SmartEVSE/SmartEVSE-2/(threads)

Thread 2 (2021-03-06):

Reading Modbus interface EVSE

rvdgaag, 2021-03-06:
Hi,

I'm trying to read registers via Modbus RTU from the EVSE with iobroker and a USB-modbus converter.
All works well reading the SDM630 I connected as well but I don't get any values for the EVSE.

As an example I try to read the register 0x00C0 Configuration value 0 socket, value 1 fixed.
I've set in the menu of the EVSE the configuration to fixed cable, still reading this register comes with value 0.

Probably the register setting is wrong in iobroker, is it a input register, a coil or a holding register ?

Since these registers are in HEX format I need to convert them, 192 right ?

Maybe the issue is that the EVSE is a Master and probably the iobroker (raspi 4) as well ?

Thanks for your feedback!

bobosch, 2021-03-06:
Hi,

when you use load balancing mode it's an issue with two masters. SmartEVSE sends multiple requests every two seconds - you have to try multiple times to get a valid response.

Have you tried communication when load balancing and smart/solar mode is disabled?

rvdgaag, 2021-03-06:
Thanks for the feedback,

yes I did not much better results. I was hoping to change parameters from remote, any ideas ?

bobosch, 2021-03-07:
Maybe wrong byte order. Set it on the SmartEVSE to fixed configuration and read value again.
Yes, it is a input register (FC=04).
Yes, addresses are in HEX format (0x indicates that)
Also correct settings? 9600bps 8N1 (8bit, no parity bit, one stop bit)
Do you have a modbus electric meter? Does your adapter work with this?

TonKro, 2021-04-11:
I am trying to get the data using Node-Red using ModBus module. Somehow I could not get it working.

With serial port I see the data Reqeust and Answer:

Request:
[10,4,0,0,0,20,241,126]

Answer data:
[10,4,40,0,21,0,3,0,0,0,0,0,0,0,0,0,0,0,0,0,0,0,0,0,0,0,0,0,0,0,0,63,234,121,245,63,180,28,153,62,123,167,51,113,98]

I am new with modbus, can someone explain the data? Or how can I translate this?

Using modbus I do need to have some data to read out:
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

What should be the Unit-ID / Address / Quantity?

bobosch, 2021-04-12:
No, all values from SmartEVSE are 16bit unsigned integer -> 20 registers = 40 bytes
Maybe first try reading a specific register. Use this information when you using 2.20 or older
https://github.com/SmartEVSE/SmartEVSE-2/tree/b8b6a1a2def22a2bfc3cc30be2f2ef639e2d4389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

TonKro, 2021-04-15:
That is also what I thought, but it was not working.
Apperently it is 32 bit floating:

Data of registers 0,21 0,3, 0,0, 0,0, 0,0, 0,0, 0,0, 0,0, 0,0, 0,0, 0,0, 0,0, 0,0, 0,0, **63,234, 121,245, 63,180, 28,153, 62,123, 167,51,**

Phase 1: 63,234,121,245 = 1,83
Phase 2: 63,180,28,153   = 1,41
Phase 3: 62,123, 167,51 = 0,25

I did (for Node-Red) use:

var V1 = new Buffer ( [msg.payload[31], msg.payload[32], msg.payload[33], msg.payload[34] ] );
var V2 = new Buffer ( [msg.payload[35], msg.payload[36], msg.payload[37], msg.payload[38] ] );
var V3 = new Buffer ( [msg.payload[39], msg.payload[40], msg.payload[41], msg.payload[42] ] );

var msg1 = {payload:V1};
var msg2 = {payload:V2};
var msg3 = {payload:V3};

return [msg1,msg2,msg3];

And then convert msg1/2/3 these to floating.

However I cannot find this information back in the documentation? Or do I read the wrong documents?

bobosch, 2021-04-15:
Sorry, I mixed it up. SmartEVSE are 16bit integers, Sensorbox has 32bit float.
Yes, Sensorbox code and documentation is not published yet.
https://github.com/SmartEVSE

TonKro, 2021-04-15:
Can you explain more detailed? What is the modbus server and what is the client? I assume the SmartEVSE (master) does do the request ([10,4,0,0,0,20,241,126] CRC), and the Sensorbox does reply and writes into the SmartEVSE with eg data:
[10,4,40,0,21,0,3,0,0,0,0,0,0,0,0,0,0,0,0,0,0,0,0,0,0,0,0,0,0,0,0,63,234,121,245,63,180,28,153,62,123,167,51,113,98]?
Is there a somewhere an overview?

mstegen, 2021-04-16:
The master (SmartEVSE) requests the data from the Sensorbox , or other modbus kWh meter.
The Sensorbox or kWh meter, replies with the requested data.

The measurement data from the Sensorbox 1.5/2.0 is in float32 (one float32 for each phase)

 ```
 Register  Register
  Address   length (16 bits)
  0x0000      1       Sensorbox version 1.5           = 0x000F
  0x0001      1       DSMR Version(MSB), CT's (LSB)   = 0x0003         
  0x0002      2       Volts L1 (32 bit floating point), Smartmeter P1 data. Unused on Sensorbox 1.5
  0x0004      2       Volts L2 (32 bit floating point), Smartmeter P1 data. Unused on Sensorbox 1.5
  0x0006      2       Volts L3 (32 bit floating point), Smartmeter P1 data. Unused on Sensorbox 1.5
  0x0008      2       Amps L1 (32 bit floating point), Smartmeter P1 data. Unused on Sensorbox 1.5
  0x000A      2       Amps L2 (32 bit floating point), Smartmeter P1 data. Unused on Sensorbox 1.5
  0x000C      2       Amps L3 (32 bit floating point), Smartmeter P1 data. Unused on Sensorbox 1.5
  0x000E      2       Amps L1 (32 bit floating point), CT imput 1
  0x0010      2       Amps L2 (32 bit floating point), CT input 2
  0x0012      2       Amps L3 (32 bit floating point), CT input 3
```

TonKro, 2021-04-16:
Clear overview thanks that makes much sense.

In my example for register 0 and 1:
0,21 0,3, (decimal)
Register 0x0000 0x00 0x15    Which sensorbox version is this?
Register 0x0001 0x00 0x03

mstegen, 2021-04-16:
That's version 2, also indicates grid type and grid rotation:
`
0x0014 (2 lsb mirror the 3/4 Wire and Rotation configuration data)
0x0015 = 4 wire, CCW rotation
0x0016 = 3 wire, CW rotation
0x0017 = 3 wire, CCW rotation
`

TonKro, 2021-04-16:
Thanks a lot for your help.

Thread 3 (2021-03-21):

SPM1-AC Temco current sensor compatibilty ?

NicolasFOVET, 2021-03-21:
Hi :)
Sorry if it's the wrong place to ask for this, but I'm really interested in building a charge station with the Smart EVSE and I was wondering if it could be compatible with the RS458/Modbus SPM1-AC Temco meter. The datasheet is here : https://downloads.temcocontrols.com/file/single-phase-power-meterwith-internal-ct/brochure_pdf/latest

Thanks for your great work ! :)
Nicolas

bobosch, 2021-03-21:
Hi!

No, only 3-phase electric meter are currently supported.

NicolasFOVET, 2021-03-22:
Ok, understood.
But, Smart ESVE is compatible with a single phase installation, right ? If I go with the sensorbox v1.5, do I have to connect all 3 clamp sensors ?

mstegen, 2021-03-23:
Yes, the SmartEVSE will work on one phase installations too.
If you use the Sensorbox 1.5 or 2 you can connect up to 3 CT's. If you connect only one, that will work as well.

Thread 4 (2021-03-25):

Eastron SDM630 config

wbitholedotbe, 2021-03-25:
I bought the smart evse with sensor box. I also bought the eastron SDM630 v2. How to configure the eastron so it will show the consumption of the charger on the display?

mstegen, 2021-03-26:
You need to enter the setup menu of the Eastron, and set the modbus address (Set Addr) on the SDM630 to a number >10 , for example 101.
Set the baudrate ( Set Baud) to 9.6k
Set the parity (Set Pari) to NONE
Set the stop bit (Set Stop) to 1

Then on the SmartEVSE set the "EV METER" option to Eastron.
set the modbus address "EV ADDR" of the meter to the same address as you used on the SDM630 (so here 101)

Connect the RS485 wires to the A and B terminals of the meter.
If the connection is working, you will see a telephone symbol on the display of the meter.

wbitholedotbe, 2021-03-26:
Will try it this weekend. Thank you.

fluppie, 2021-08-06:
I have a monophase setup. Does this also work with the Eastron SDM220?

fluppie, 2021-08-11:
Can it be as simple by changing the custom unit to the 1P modbus register?
The SDM630 uses 0x34 and the SDM120/220/230 uses 0x0C.

`{"Eastron1F", ENDIANESS_HBF_HWF, 4, MB_DATATYPE_FLOAT32,    0x0, 0,    0x6, 0,   0x0C, 0,  0x156, 0}  // Last entry! // use 0x0C for single phase SDM120/220/230 instead of 0x34`

Should one create a case EM_CUSTOM?

bobosch, 2021-08-12:
It depends how you want to use the single phase electric meter.
I don't have this electric meter so I could only speculate...

For current measurement (smart or solar charging):
You have to use EM_EASTRON, as there is a special handling of the current measurement (case EM_EASTRON...)
I think it won't work with the SDM220, because there is no power measurement. Maybe with the SDM230, it depends on how the electric meter response the the modbus request on register 0x06 with 6 requested values (3x phase current, 3x phase power). When it response with the 1st phase current and power information, and the other values 0, it should work out of the box.

For power and energy measurment (ev meter):
You can use EM_CUSTOM with register 0x0C for power measurement (as you wrote) and 0x156 for energy measurement and it should work

Feedback is welcome!

fluppie, 2021-08-13:
I would think it can work, have you seen the registers overview from the Reaper7 repository?
Starting from line 100: https://github.com/reaper7/SDM_Energy_Meter/blob/8bda969f312cfafa5a26506da8ac9b42d4fb38ca/SDM.h#L100
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

So 0x06 gives my current and 0x0C my power, the same address as for Phase1_Current and Phase1_Power. The registers of Phase2 and 3 are not used by the SDM220, so I don't know what the plugin does if that value is not available. Like you wrote, if it's zero, it's probably going to work just fine.
I would also think when the system needs the total system power 0x0C would be right instead of 0x34 in a 3 Phase system.

Maybe we can create Eastron1F and Eastron3F in EVSE.h ? I think people with mono phase systems wouldn't mind :-).

mstegen, 2021-08-16:
I've got confirmation from a customer that the Eastron SDM230 modbus works fine. If the SDM220 uses the same registers then it might also work.

fluppie, 2021-08-16:
It is for most addresses.

`{"Eastron",   ENDIANESS_HBF_HWF, 4, MB_DATATYPE_FLOAT32,    0x0, 0,    0x6, 0,   0x34, 0,  0x156, 0}, // Eastron SDM630 (V / A / W / kWh) max read count 80`

0x0 for Voltage is the same for SDM630/SDM230/SDM220
0x6 for current is the same for SDM630/SDM230/SDM220
0x34 is only used by SDM630 for SDM_TOTAL_SYSTEM_POWER, NOT supported by SDM230/SDM220. 1Phase meters use 0x0C as address for power.
0x156 for SDM_TOTAL_ACTIVE_ENERGY is the same for SDM630/SDM230/SDM220

Or is the 0x34 address not important? Maybe the load balancing uses current instead of power?

Can adding a line of code work and create an option for 1Phase and 3Phase meters?
`{"Eastron1F",   ENDIANESS_HBF_HWF, 4, MB_DATATYPE_FLOAT32,    0x0, 0,    0x6, 0,   0x0C, 0,  0x156, 0}, // Eastron SDM630 (V / A / W / kWh) max read count 80`
`{"Eastron3F",   ENDIANESS_HBF_HWF, 4, MB_DATATYPE_FLOAT32,    0x0, 0,    0x6, 0,   0x34, 0,  0x156, 0}, // Eastron SDM630 (V / A / W / kWh) max read count 80`

Thread 8 (2021-04-09):

Using RS485 <--> ETH <--> RS485 between SmartEVSE and Sensorbox

GerardFianen, 2021-04-09:
Solved.

jimon, 2021-09-24:
If someone else needs this, I was able to partially solve this with two mikrotik KNOT devices and one RPi because currently KNOT's cannot pass modbus master commands (they just ignore it), more info https://forum.mikrotik.com/viewtopic.php?p=875143
And here the code for the proxy app I made for RPi https://github.com/jimon/evseproxy

There are probably some other RS485<->ETH bridges on the market that can pass master commands transparently.

Closed 2021-04-15.

Thread 11 (2021-04-27):

Proposal for a SmartEVSE to MQTT bridge to enable integration into home automation

PA1RB, 2021-04-27:
I am about to start working on a solution to integrate SmartEVSE into home automation, in my case that would be [Home Assistant](https://www.home-assistant.io/).

The idea is to create an additional physical ~~slave~~ (pardon: [server](https://www.modbus.org/docs/Client-ServerPR-07-2020-final.docx.pdf)) device (let's call it a bridge), hooked to the Modbus RTU bus of the SmartEVSE system, that holds a copy of certain registers of the SmartEVSE controllers, which can be updated and read by the primary SmartEVSE controller. The value of these registers is in-turn exchanged by the bridge with Home Assistant based on the MQTT protocol over ethernet.

In a first iteration, the primary EVSE controller will only write information to the bridge. This will allow the home automation system to monitor the SmartEVSE controller's states and certain values.

In a future iteration, the primary EVSE controller will also read information from the bridge that was pushed there from the home automation system, thereby influencing the charge process based on various rules within Home Assistant. These rules can include planning charge time and charge speed based on planned travel schedules, cost of electricity and/or knowledge from the car itself like battery state, etc.

I plan to take an approach where I leave the operation of SmartEVSE as-is, and ensure it will continue to operate as usual and autonomously in case of absence of a connection to the bridge. Also, none of the EVSE safety-related parameters shall be write-accessible through MQTT.

Potentially the device may include the functionality of a Sensorbox to reduce the number of required devices, but I do not pursue that myself.

Any interest in or thoughts on this approach?
Anyone who already started on a similar solution?

bobosch, 2021-04-28:
We like to implement the smart features also in the sensorbox, which has a wifi interface as well. When sensorbox is present, it could take control over the modbus communication (act as master device), and it would be able to do additional tasks like provide information over Modbus TCP or act as RTU <-> TCP gateway.

PA1RB, 2021-04-28:
OK, excellent news, and the approach to let the Sensorbox take the ~~master~~ (sorry, [client](https://www.modbus.org/docs/Client-ServerPR-07-2020-final.docx.pdf) :innocent:) role in that set-up makes perfect sense to me.
In case Sensorbox-2 already has the required hardware capabilities, and the team is willing to publish code and schematics, I would be happy to contribute to the concept and/or the code.
If the feature is already in development and you want to hold-off publication until a minimal viable product is ready, can you then share a guesstimated target date please?

pc1e, 2021-05-10:
Excellent news, i'm struggling to get te communication between the evse and sensorbox via an RS485 - wifi gateway as the distance between is not convenient to overcome by cable, too match digging. No luck so far.
If this is build in functionality that would be a great help.
Any progress on this part is very much appreciated.
Any procedure to activate the wifi part in the Sensorbox 2 will be helpful as wel

TonKro, 2021-06-05:
You can use Node-Red (with Raspberry PI) make MQTT possible with a RS485 USB adapter.

Via this way you also can make the MODBUS transfer via WiFi or Lan.

IgorYbema, 2021-08-15:
Any news in enabling the wifi in the sensorbox? I would also like to intergrate into my home automation and before I put too much effort in trying to add my own modbus master on a bus which already has a master I would like to know if the sensorbox code is almost ready for wifi. Also when will that code (if ever) be available for public?

fluppie, 2021-08-20:
You can maybe check this code and see if you can use it? https://github.com/ict-one-nl/mqtt-to-smartevse

IgorYbema, 2021-08-24:
> You can maybe check this code and see if you can use it? https://github.com/ict-one-nl/mqtt-to-smartevse

This is exactly what I meant with a double modbus master which I would like to prevent.

mintgroen, 2021-08-24:
> Any news in enabling the wifi in the sensorbox? I would also like to intergrate into my home automation and before I put too much effort in trying to add my own modbus master on a bus which already has a master I would like to know if the sensorbox code is almost ready for wifi. Also when will that code (if ever) be available for public?

I've heard from Stegen that the Sensorbox V2 PCB and source code will be published this week.

Egyras, 2021-11-23:
Some users have existig own smart meters and for example in detached garage from house sometimes is hard to route any additional wires from modbus smart meter to EVSE box. So MQTT integration sounds good when you have some home automation runing, would be nice that Sensorbox could "subscribe" via mqtt and lookup for power usage values in smart House systems like Home Assistant, Openhab and etc.

rmeekers, 2022-04-19:
Any updates on this?

IgorYbema, 2022-04-19:
This guy is making modification to the smartevse v3 code: https://github.com/serkri/SmartEVSE-3
You need a v3 smartevse for this though.

rmeekers, 2022-04-19:
thanks @IgorYbema

Thread 12 (2021-05-10):

How to determine the Charging States from Terminal.

qasimali-byte, 2021-05-10:
hi, I am reading the EVSE terminal using python3. I want to read the states (Connected, Charging, Disconnected) which are not available in the terminal. But when I go through the EVSE C code I figure out (State A, State B, State C) are available in the code. but these settings are not available on the terminal. Could you please help me out with the issue?
@wido @bobosch @Links2004 @mstegen @maximevince

qasimali-byte, 2021-05-12:
@bobosch thanks for your comment. could you please answer me that can i connect the Following Chint Smart Energy meter with Smart EVSE over the modbus and show the Chint meter values on the terminal ?
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

qasimali-byte, 2021-05-12:
> Currently you can read the charge state only over Modbus (RS485),
> https://github.com/SmartEVSE/SmartEVSE-2/tree/b8b6a1a2def22a2bfc3cc30be2f2ef639e2d4389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

so as we already reading the terminal through rx,tx availbale on the Smart EVSE . so you are saying if  i want to read the states values then we should communicate with Smart EVSE over the RS-485 and then read the States Values ?

mstegen, 2021-05-12:
If you are using the terminal, you can also send the serial command STATE?
The SmartEVSE will answer with:

EVSE0:B(16.0A),EVSE1:C(12.0A),EVSE2:A(0.0A),EVSE3:A(0.0A),EVSE4:A(0.0A),EVSE5:A(0.0A),EVSE6:A(0.0A),EVSE7:A(0.0A)

qasimali-byte, 2021-05-12:
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

Thanks, @mstegen for your comment. as my question was I want to determine the states (Connected, Charging, Disconnected) I hope you understood my question. but as you answered that if I send the serial command State over the terminal. the answer of the Smart EVSE will be EVSE0:B(16.0A),EVSE1:C(12.0A),EVSE2:A(0.0A),EVSE3:A(0.0A),EVSE4:A(0.0A),EVSE5:A(0.0A),EVSE6:A(0.0A),EVSE7:A(0.0A) . but how can I extract the state from this line that Currently what is the state?

mstegen, 2021-05-12:
If it's state A, then it's Disconnected. In the above example EVSE2-7 are Disconnected.
State B is Connected (only EVSE0 , the Master in this case)
State C is Charging (only EVSE1 , it's charging at 12.0A at the moment)

qasimali-byte, 2021-05-12:
> If it's state A, then it's Disconnected. In the above example EVSE2-7 are Disconnected.
> State B is Connected (only EVSE0 , the Master in this case)
> State C is Charging (only EVSE1 , it's charging at 12.0A at the moment)

okay. so you are talking about the **LOADBL**  when we enable this we have Master, Node 1----Node 7. so we can determine the states accordingly. am I right?

qasimali-byte, 2021-05-12:
> If it's state A, then it's Disconnected. In the above example, EVSE2-7 is Disconnected.
> State B is Connected (only EVSE0, the Master in this case)
> State C is Charging (the only EVSE1, it's charging at 12.0A at the moment)
As we give only those commands to the Terminal which are available on the terminal. **STATE** command is not available on the terminal.

mstegen, 2021-05-12:
You should use STATE**?**
Yes It will display all states for all Nodes including the Master.
The STATE? command only gives usable results on the Master.

qasimali-byte, 2021-05-24:
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

hi! @mstegen  i run STATE? commond in Master and get the EVSE0:B(16.0A),EVSE1:C(12.0A),EVSE2:A(0.0A),EVSE3:A(0.0A),EVSE4:A(0.0A),EVSE5:A(0.0A),EVSE6:A(0.0A),EVSE7:A(0.0A) could you please tell me in the above result which is my EVSE . as There are two EVSE0:B(16.0A),EVSE1:C(12.0A) displaying how can i recognize which is my EVSE ?

mstegen, 2021-05-24:
The Master is EVSE0

qasimali-byte, 2021-05-24:
Ok, thanks. But what about EVSE1 who is also displaying some current. Is it
that way

EVSE 0--- Master
EVSE 1--- Node1
.....
EVSE 7----Node 7

On Mon, May 24, 2021, 5:41 PM Michael Stegen ***@***.***>
wrote:

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

qasimali-byte, 2021-05-25:
> The Master is EVSE0

Ok, thanks to @mstegen . But what about EVSE1 who is also displaying some current. Is it
that way

EVSE 0 --->Master
EVSE 1 --->Node1
.
.
EVSE 7--->Node 7

mstegen, 2021-05-25:
Yes that's correct.

qasimali-byte, 2021-05-25:
okay. Thanks, It's means when we connect Something with Node1---Node7 they will also display their status and Currents.?

mstegen, 2021-05-25:
Yes, for each connected controller the current STATE and max charge current is displayed.

qasimali-byte, 2021-05-25:
Ok, thanks for the clarification.

On Tue, May 25, 2021, 1:00 PM Michael Stegen ***@***.***>
wrote:

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

qasimali-byte, 2021-06-02:
hi , @mstegen  i am facing the issue regarding getting the States . as there is no Curennt Showing in EVSE Screen as well as on the STATE? Commond . can you please help me out where i am doing mistake .
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

qasimali-byte, 2021-06-02:
hi, i am facing the issue regarding getting the States . as there is no
Current Showing on EVSE Screen as well as on the STATE? Command . can you
please help me out where I am doing a mistake

On Tue, May 25, 2021 at 1:05 PM Qasim Warraich ***@***.***>
wrote:

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

mstegen, 2021-06-02:
Somehow the sensorbox is not measuring any current. Are you using a sensorbox or are you emulating it in software?
If you can send a picture of your complete setup, that might help.

qasimali-byte, 2021-06-02:
This is the picture of the circuit which I am using. 2nd as you mentioned
that am I emulating the current from software. Could please how can I
emulate the from the software .

On Wed, Jun 2, 2021, 5:40 PM Michael Stegen ***@***.***>
wrote:

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

mstegen, 2021-06-02:
You could use the Sensorbox 1.5 code as a starting point, but i guess you have that atleast partly working, otherwise the SmartEVSE will show an error message on the LCD.

qasimali-byte, 2021-06-03:
> You could use the Sensorbox 1.5 code as a starting point, but i guess you have that atleast partly working, otherwise the SmartEVSE will show an error message on the LCD.

Sorry @mstegen  i didn't actually understand. can you please explain more ?

qasimali-byte, 2021-06-03:
> Sensorbox 1.5 code

yes i am using the Sensorbox 1.5  version .but EVSE not showing the Current. How can i emulate the Current from the Software?

mstegen, 2021-06-03:
```
for (x=0; x<3 ;x++) {
                    Irms[x] = Irms[x]* CAL;
                    pBytes = (char*)&Irms[x];                                   // get raw 4 byte Double
                    Tbuffer[n++] = pBytes[3];                                   // Send MSB first
                    Tbuffer[n++] = pBytes[2];
                    Tbuffer[n++] = pBytes[1];
                    Tbuffer[n++] = pBytes[0];                                   // Send LSB last
                }
```
This is the Sensorbox code that sends the measured current to the SmartEVSE. The measured current is stored in Irms[x].
Just change the Irms[0] to let's say 30.0 and you should see the data on the SmartEVSE.

qasimali-byte, 2021-06-09:
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

hi @mstegen  i changed the code as you suggest me but i am getting same result . when i entered the STATE? commond still there is no state change information.
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

mstegen, 2021-06-09:
You asked "How can i emulate the Current from the Software"
This seems to be working.. I see 2A displayed on the LCD for each Phase. Also the CAL values in the CLI show the measured currents.
If you want to see the set charge current with the STATE? command, then you first need to start charging. Connect a EV, or emulate one with a EV simulator (a couple of resistors and and Diode)

qasimali-byte, 2021-06-09:
okay. Thanks but my main concern with the STATE? command output. Could you please help me to simulate the Circuit so i can test the STATE command? like how many resistors required or Diode and with how much value etc?

qasimali-byte, 2021-06-11:
> You asked "How can i emulate the Current from the Software"
> This seems to be working.. I see 2A displayed on the LCD for each Phase. Also the CAL values in the CLI show the measured currents.
> If you want to see the set charge current with the STATE? command, then you first need to start charging. Connect a EV, or emulate one with a EV simulator (a couple of resistors and and Diode)

hi, @mstegen I am using the Following circuit to emulate the EV and test the State? is that correct or need to rectify?
[https://www.evalbo.de/2015/02/14/typ-2-stecker-beschaltung/]
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

Thread 13 (2021-05-17):

ERROR NO SERIAL COM CHECK WIRING Should I use 120Ω termination resistors ?

henriterhofte, 2021-05-17:
I have the SmartEVSE running fw 2.20 connected to Sensorbox 2. New this weekend: (finally) also connected to the Eastron SDM630-Modbus V2 meter.

Functionally, everything works (charching, kWh counting, smart reaction to other loads to prevent MAINS overload)
but  I also get this error regularly:  ERROR NO SERIAL COM CHECK WIRING.

I used very short (10-15cm) non-twisted older phone cables with 4 non-stranded wire cores, hooked op 12V, GND, A and B for the Sensorbox-2 and hooked up A B and GND for the Eastrom

Given these errors (which do not seem to hinder the functionality):

1) Should I use twisted pair wiring even for these short RS-485 connectrions?

2) I not only connected not only A and B between SmartEVSE and  Eastron, but also GND; is this correct?

3) Should I use 120 Ω termination resistors that seems to be recommended for RS-485 bus topology wiring?

PA1RB, 2021-05-17:
Modbus over RS-485 is specified for twisted pair cabling with characteristic impedance of 120 Ohm.

In practice it is often installed with Ethernet-grade  unshielded or shielded twisted pair, which has a differential impedance of 100 Ohm.

When resistors are mounted at both far ends of the bus (between the A and B wires), each matching the differential impedance, the reflections of signals are minimized.

For such short cable runs, and the system speed of 9600 bps however, reflections are unlikely to be a problem in your case. Also cable resistance is not likely a problem.

The SmartEVSE controller has no built-in resistors. Not sure about sensorbox-2.

Perhaps there is a strong source of interference nearby (e.g. switching power supply)? In that case twisted pair cable may help, make sure to use a single pair of twisted wires to carry A and B signals. Shielded cable, with the shield connected to protective ground may also help.

Perhaps a more likely source is a bad contact or occasional short circuit (with a single small copper strand)?

And yes, signal ground should be connected in parallel with the A and B lines in Modbus installations, although this is often omitted and the installation still works (be it by chance, not by design).

martijndierckx, 2022-01-24:
I have the same issue here.
My modbus setup/devices:
- Eastron SDM630
- SmartEVSE (2.30)
- Protoss PE11 (TCP interface)

If I just interconnect the devices, everything works.
I can even set the SmartEVSE to SMART mode and read the values from the Eastron.

But, once I start polling the Eastron for data over the PE11, I get the same 'NO SERIAL COM' error.
Code I use to poll the Eastron: https://github.com/martijndierckx/sdm630-modbus-tcp

Any ideas?

Thread 14 (2021-05-22):

Update from 2.06 and solar power

LolDeibid, 2021-05-22:
Hi!

I'm currently working on my own solarpower system at home. I've wallbox with SmartEvse (2.06v), and i'm looking how to update it to 2.2v to make it works with a sensorbox2 and use only solar energy.

In addition, i'm looking for some info about what do i need to conect sensorbox to the inverter. As i read Stegen website, i shoul use a "smart meter" and they have a tested list, but... i really don't know what is a sensor box. I'm new on solar energy world and not english expert haha.

Should i connect these "smart meter" to the inverter? how?

In my mind:

Current phase entry to home->Current Transform (i got it)->SensorBox V2 (actually have a v1.5)->SmartMeter (don't know what it is haha). Is this right? If OK, next... From Smartmeter in advance... What is the next step??

SmartMeter is a necessary part of a solar energy installation? If i use a Huawei Sun2000 inverter, can i connect any of those smart meters related previously?

Sorry for this, really new on this world.

Very thankful for your helping.

Regards,

David.

LolDeibid, 2021-05-22:
Sorry, i forgot something:

To update my actual 2.06v to 2.2v, it's the same way published on mainsite wiki "Building and Programming" guide??

Any thing that i should take care or just know??

Thanks!

Thread 15 (2021-05-30):

Read / Write Modbus

TonKro, 2021-05-30:
I am trying ro read / write registers via modbus but the EVSE does not answer.

- Configured 8600 8 N 1
- Checked the bus if the data is there, which is
- Eg ty to read out register 1

Send out: [1,4,0,1,0,1,96,10]

Also tried as other Unit-ID like 2: [2,4,0,1,0,1,96,57]

No answer from the Smart EVSE.

When enable Smart / Loadbalancing. The data is there and working correct between the EVSE and Sensorbox.

What am I doing wrong?

bobosch, 2021-05-30:
Which version of SmartEVSE do you use?

TonKro, 2021-05-31:
Good question, the specific version I do not know, I did purchase it via stegen.com on the website like 1-2 Months ago assuming I got the most recent version by then.

mstegen, 2021-05-31:
When you enter the setup menu, the software version should be visible on the LCD.
The version is also shown when powering up the controller for two seconds.

TonKro, 2021-05-31:
Thanks.
Just checked, it is indeed v 2.20

bobosch, 2021-05-31:
Please use this modbus manual
https://github.com/SmartEVSE/SmartEVSE-2/tree/b8b6a1a2def22a2bfc3cc30be2f2ef639e2d4389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

Try to read register 0x00A0

TonKro, 2021-05-31:
Which Unit ID should be used?

bobosch, 2021-05-31:
It should be 0

TonKro, 2021-06-01:
As far as I am aware of could the unit id only from 1-255?

TonKro, 2021-06-01:
Maybe you can share a serial read and write command of a certain register of the EVSE?

bobosch, 2021-06-01:
Yes, 0 is broadcast address, in version 2.20 the load balancing option defines the modbus address (0=disabled, 1=master, 2=node 1....). will be fixed in next release.

TonKro, 2021-06-03:
What does the unit expect with read and write command on the serial bus?

Thread 17 (2021-06-22):

is that any possible way to get the State (Charging,Disconnect,Connected)  and the Other configuration Values(Max Power ,Min Power) Parrallely?

qasimali-byte, 2021-06-22:
Hi @wido @bobosch @Links2004 @mstegen @maximevince  I am Working on the Smart EVSE. I Connected the EVSE with Compute Module 3+ over the USART, and I am able to get the Values from the Terminal and set the EVSE Configuration Values through the terminal. actually, my concern to get the STATE info and the other configuration parallelly from the EVSE, as per my understanding about EVSE  respond only one Command at a time. so is that any other way to get the STATE from the EVSE parallel to the Configuration.

bobosch, 2022-01-04:
https://github.com/SmartEVSE/SmartEVSE-2/issues/12#issuecomment-839608368

Closed 2022-01-04.

Thread 18 (2021-08-20):

Smart mode

gransat, 2021-08-20:
Hi,
I have problem with smart and solar mode, I cannot get current below zero from current sensor. Current transformator is OK,
it gives +mV and -mV when it s clip oposide, but it is still +A, I can t get -A on controller.
Can you help me solve this problem?

bobosch, 2021-08-20:
Some electric meter use unsigned current values.
What device do you use for current measurement?

gransat, 2021-08-20:
I have original current transformers and sensorbox v 1.7 from stegen dealer. Controller is ver.2.20.

mstegen, 2021-08-23:
Only Sensorbox 2 (black enclosure) can measure the direction of the current. If you recently bought the Sensorbox 1.5 you can send it back and upgrade to the Sensorbox 2.

gransat, 2021-08-24:
Thanks for replay,

can you sen dme information, when will be controller available, on eshop is out of stock,

s pozdravom  Granec

GRANSAT s.r.o.

Košická Belá 595, 04465 Košická Belá

Tel.: +421905901086

IČO: 45371962

IČ DPH:SK 2022969784

 ***@***.***> ***@***.***

 <http://www.gransat.sk/> www.gransat.sk

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

Closed 2021-08-29.

Thread 21 (2021-09-13):

IsetBalanced what is the reason of the 80A hardcoded limit?

fluppie, 2021-09-13:
While browsing the code I saw that IsetBalanced has a 80A hardcoded limit, what's the idea behind this?
After booting the unit it quickly goes 60-70-80A. My mains max is set to 40A and the EV circuit to 32A.

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

mstegen, 2021-09-14:
When starting to change IsetBalanced will be set to the max current of the EV circuit. The 80A hard limit was added before the EV circuit option was available. I think it can be removed now.
It was mainly added because if there is no limit, it will keep increasing over time (when not charging).

Thread 22 (2021-09-24):

Advice how to implement charging over night

jimon, 2021-09-24:
Hi, I would like some advice how to implement charging during specific periods and/or remotely controlled.

A super naive way I can do right now is to MITM Sensorbox report and replace it with predefined frame that tells the controller "no energy is available", but that will result in my car complaining that charging cannot be started.

I could also expand solar timer logic to achieve something similar.

Which way should I take? Thanks!

jimon, 2021-09-24:
Guess the idea of sensorbox becoming the master device is better, than it could run this logic and control charging stations modes.

PA1RB, 2021-12-17:
@mstegen on the Sensorbox: _I'll release a version of the PIC firmware soon that will only do the CT measurements, and will not use the RS485 bus, nor use the P1 port. On this version the ESP32 will handle everything else._

Is this already on the horizon, or any support the team can give?

mstegen, 2022-02-10:
@PA1RB I've uploaded the code for the Sensorbox-2 to Github. It's still acting as a slave/node to the SmartEVSE, but all the modbus handling is now done by the ESP. Also added a way for the SmartEVSE to retrieve the time/date so charging at a specific time/day could be added to the SmartESVE code.

Thread 24 (2022-01-09):

Nodejs integration

martijndierckx, 2022-01-09:
Hi all

Just wanted to let you guys know, I'm working on an integration for Nodejs.
The first alpha version allows you to poll for all the values. It doesn't yet allow you to set them. That's for next weekend :-)

Link: https://github.com/martijndierckx/node-smartevse

martijndierckx, 2022-01-09:
I do have some trouble interpreting some of the Modbus registers. A bit more documentation on what each line does would come in handy.

kennyschuoler, 2022-01-10:
Hey Martijn,

What more info do you need ? I can try if i can help you : I just wrote a first version of a custom integration for home assistant ( https://github.com/kennyschuoler/homeassistant-smartevse )

fluppie, 2022-01-10:
@kennyschuoler what HW interface do you have towards the SmartEVSE? Modbus over TCP?

kennyschuoler, 2022-01-11:
@fluppie i'm using a Waveshare RS232485 ( https://www.amazon.de/-/en/gp/product/B07RQSPYFV/ref=ppx_yo_dt_b_asin_title_o01_s00?ie=UTF8&th=1 ) ( mainly because this is located in my electrical box , otherwise you can also use the smaller RS485 version )
I have configured it currently with Modbus RTU over TCP , but depending on the config in Waveshare it is also possible to use Modbus over TCP ( i was able to get the values )

fluppie, 2022-01-11:
Is this module acting as a second Modbus master? Or is it invisible to the SmartEVSE and eventual kWh meters? Myself I have 2x Eastron SDM230 for house load and EV charged kWh's. In the future one for Solar could join the party.
Would a ESP32 be able to be a RTU to TCP bridge or is your software specifically made for the Waveshare module?

https://github.com/eModbus/eModbus

kennyschuoler, 2022-01-11:
To sIt is indeed acting as a second Modbus master, therefor i have to make sure that i only request data every +30 secs ( I am using the latest master branch software  ).

To give you an idea : My setup contains a sensorbox v2, 2 x Smart EVSE ( master + node ) devices and 2 x Eastron SDM630 modbus v2 devices.

The sensorbox is connected via RS485.

I also have solar panels with an energy meter, but this is completely isolated.

The 2 eastron devices i have connected to 1 Waveshare device, and the other Waveshare device contains the 2 Smart EVSE devices and the sensorbox. They share the exact same configuration, so it should be able to connect them all to the same device.( just make sure that the eastron devices use an unused modbus address )

Hope this helps !

Thread 25 (2022-01-11):

Car plugged in + Car battery state

kennyschuoler, 2022-01-11:
I made an integration for Home Assistant but to have a complete automation i'm missing some information :

- Is there a possibility to detect if a car is plugged in ( which can be published via modbus ) ?
- Is there a possibility to read the EV battery percentage ? ( If i'm not mistaken this information is shared via the digital protocol, but i couldn't find any starting point of how this protocol works )

Could you please advice me how this can be achieved ?

Thanks !

martijndierckx, 2022-01-11:
0x0000 state should give you this info. B = Connected, C = Charging

kennyschuoler, 2022-01-11:
Thanks ! Then only 1 question remains :

Is there a possibility to read the EV battery percentage ? ( If i'm not mistaken this information is shared via the digital protocol, but i couldn't find any starting point of how this protocol works )

martijndierckx, 2022-01-11:
Afaik this is not possible. Certainly not in a standardised way. Some cars might publish this information on the CP/PP pins, but this would be in a proprietary way … I think.

But … maybe you could achieve the same via a cloud api of the car brand?

fluppie, 2022-01-11:
Nope, mode 3 chargers are not able to read the EV battery it's SoC. If I'm right, mode 4 chargers can, like these DC chargers.
Indeed, using for example BMW Connected drive etc.
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

kennyschuoler, 2022-01-11:
Aaah to bad, thanks for the information ! I did not know that only mode 4 chargers are able to share that information. That explains why i couldn't find any information :p

I will indeed then use the BMW API in this case, i hope the information is near real-time while charging ( i'm using the values to keep a charging history )

Thanks @martijndierckx and @fluppie !

kennyschuoler, 2022-01-11:
Maybe a small addition, there are however mode 2 chargers available, which can display the battery charging state :

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

Any idea how that works  ?

kennyschuoler, 2022-01-11:
Maybe it is possible based on the Pilot voltage ? But then it seems it should be possible ( but it is really not accurate )

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

Reference : https://batteryuniversity.com/article/bu-903-how-to-measure-state-of-charge

mstegen, 2022-01-11:
The SOC of the battery is not readable from the EVSE. There are however way's the EVSE can detect that the battery is almost full. Most cars will taper down the charge current when they approach 100% SOC.
This is detectable with charging equipment.

This only works when charging at high charge current, and when charging to a high SOC level. And the tapering will only happen in the last minutes, so in practice it's not very useful.
Maybe the above EVSE has a built in energy meter to count the charged energy, and it can estimate the SOC this way?

fluppie, 2022-01-11:
https://en.wikipedia.org/wiki/Combined_Charging_System
Charging communication

Unlike the connector and inlet, which depend on the geographical location, the charging communication is the same around the globe. Generally two types of communication can be differentiated.

Basic signaling (BS) is done using a pulse-width modulation (PWM) signal which is transferred over the control pilot (CP) contact according to IEC 61851-1. This communication is used for safety-related functions, indicating for example if the connector is plugged in, before contacts are made live (or energized) and if both charging station and electric vehicle are ready for charging. AC charging is possible using the PWM signal only. In this case the charging station uses the duty cycle of the PWM to inform the onboard charger of the maximum available current at the charging station (A pulse width of 5% indicates that HLC shall be used).
High-level communication (HLC) is done by modulating a high-frequency signal over the CP contact (also known as Power Line Communication or PLC) to transfer more complex information, which may be used e.g. for DC charging or for other services such as "plug and charge" or load balancing. High-level communication is based on the standard DIN SPEC 70121 and the ISO/IEC 15118-series.

https://en.wikipedia.org/wiki/IEC_61851

Ik denk via de API nog het makkelijkste :-) ?

martijndierckx, 2022-01-11:
I think it’s a proprietary protocol which allows this. But if available, it will be different for every car brand.
________________________________
Van: Michael Stegen ***@***.***>
Verzonden: Tuesday, January 11, 2022 9:29:46 PM
Aan: SmartEVSE/SmartEVSE-2 ***@***.***>
CC: Martijn Dierckx ***@***.***>; Mention ***@***.***>
Onderwerp: Re: [SmartEVSE/SmartEVSE-2] Car plugged in + Car battery state (Issue #25)

The SOC of the battery is not readable from the EVSE. There are however way's the EVSE can detect that the battery is almost full. Most cars will taper down the charge current when they approach 100% SOC.
This is detectable with charging equipment.

This only works when charging at high charge current, and when charging to a high SOC level. And the tapering will only happen in the last minutes, so in practice it's not very useful.
Maybe the above EVSE has a built in energy meter to count the charged energy, and it can estimate the SOC this way?

—
Reply to this email directly, view it on GitHub<https://github.com/SmartEVSE/SmartEVSE-2/issues/25#issuecomment-1010335141>, or unsubscribe<https://github.com/notifications/unsubscribe-auth/AA6KD7XNHCEXEXWRL5S2N7DUVSHLVANCNFSM5LWMBJ7A>.
Triage notifications on the go with GitHub Mobile for iOS<https://apps.apple.com/app/apple-store/id1477376905?ct=notification-email&mt=8&pt=524675> or Android<https://play.google.com/store/apps/details?id=com.github.android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>.
You are receiving this because you were mentioned.Message ID: ***@***.***>

kennyschuoler, 2022-01-11:
API it is indeed ! :p Thanks all !

fluppie, 2022-01-16:
I found this regarding Charging Protocols: https://www.openchargealliance.org/downloads/

Closed 2022-01-11.

Thread 26 (2022-01-11):

No response for 'state' over Modbus on FW 2.30

martijndierckx, 2022-01-11:
Hi

Just updated my SmartEVSE to 2.30.
Where I was able to get the state from address 0x00A0 on FW 2.13, I'm not able to get in from 0x0000 on FW 2.30.
Other addresses seem to work fine.

Any ideas?

Kind regards
M

kennyschuoler, 2022-01-11:
I have the same issue it seems ( @martijndierckx thank you for your previous remark :) ).
Tomorrow i'll compile the latest version and check if it is already fixed in the meantime ( The charging current is also not working as it should , but looking at the commits that should be fixed )

mstegen, 2022-01-11:
Please note that the modbus registers changed between v2.30 and <=2.20

use this list for 2.20 or earlier:
https://github.com/SmartEVSE/SmartEVSE-2/tree/b8b6a1a2def22a2bfc3cc30be2f2ef639e2d4389#modbus
and the default one for v2.30:
https://github.com/SmartEVSE/SmartEVSE-2/tree/b8b6a1a2def22a2bfc3cc30be2f2ef639e2d4389#modbus

martijndierckx, 2022-01-11:
I’m using the new list. Everything seems to work except the first state address.
________________________________
Van: Michael Stegen ***@***.***>
Verzonden: Tuesday, January 11, 2022 8:56:40 PM
Aan: SmartEVSE/SmartEVSE-2 ***@***.***>
CC: Martijn Dierckx ***@***.***>; Mention ***@***.***>
Onderwerp: Re: [SmartEVSE/SmartEVSE-2] No response for 'state' over Modbus on FW 2.30 (Issue #26)

Please note that the modbus registers changed between v2.30 and <=2.20

use this list for 2.20 or earlier:
https://github.com/SmartEVSE/SmartEVSE-2/tree/b8b6a1a2def22a2bfc3cc30be2f2ef639e2d4389#modbus
and the default one for v2.30:
https://github.com/SmartEVSE/SmartEVSE-2/tree/b8b6a1a2def22a2bfc3cc30be2f2ef639e2d4389#modbus

—
Reply to this email directly, view it on GitHub<https://github.com/SmartEVSE/SmartEVSE-2/issues/26#issuecomment-1010311850>, or unsubscribe<https://github.com/notifications/unsubscribe-auth/AA6KD7XE6DX5QQ6VSDC4HETUVSDPRANCNFSM5LXEYLWA>.
Triage notifications on the go with GitHub Mobile for iOS<https://apps.apple.com/app/apple-store/id1477376905?ct=notification-email&mt=8&pt=524675> or Android<https://play.google.com/store/apps/details?id=com.github.android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>.
You are receiving this because you were mentioned.Message ID: ***@***.***>

kennyschuoler, 2022-01-11:
@mstegen It is a possibility that i have a slightly different issue then @martijndierckx , if it is the case i'll create a new issue

I am also using the latest registers - see screenshot ( Everything else is working as expected - ignore the the callibration value, i still need to display that one correctly )
- The charging current is 160 A ( while it is not charging atm, this is already fixed based on the commits )
- The state that is returned are numeric values ( i suppose 0=A, 1=B, 2=C, ... )
- The state is always 0 except when i set the access bit to 1 ( allowed ) and i switch at 22h from solar to smart, then the state is set to 2 ( but it seems i don't get the status 1 ). When the battery is full, i set the access bit back to 0 . Then it seems the state is shortly set to 1
- At 7h in the morning, i set the access bit again to 1 and switch from smart to solar, then it also shortly shows the state=1  ( plugged in ) but then it returns to 0
  --> In case this is not working as expected, it'll probably have to do something with the access bit and the state update

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

rvdgaag, 2022-02-17:
@kennyschuoler  How did you manage to read the values of the Smart EVSE ?

I have also fw 2.30 installed but can't get any values via modes from the smartens, both SDM630 eastern units reply fine.

Any suggestions ??

Thread 27 (2022-01-15):

Use of Access Bit

kennyschuoler, 2022-01-15:
Hi @bobosch , @mstegen ,

What is the desired use for the access bit, is it the purpose to enable/disable charging in general, or only in combination with e.g. the RFID ?
I currently don't use RFID or any other access verification , but i do use the access bit in my automation to disable charging at dynamic moments (e.g. i first let my house battery fully charge on solar, only then i enable access bit ( solar is automatically set at 7h in de morning).
If this is not the intended use, then i will have a look and introduce something similar. If it is the intended use, then i will verify if everything works as designed ( e.g. switching from smart to solar "resets" the access bit)

Thanks !

Thread 32 (2022-01-23):

How to enter to bootloader now?

gxnse, 2022-01-23:
Hello. I deleted this in the EVSE.c file:

```
            if ((timeout == 0) && !(Error & CT_NOCOMM))                         // timeout if CT current measurement takes > 10 secs
            {
                Error |= CT_NOCOMM;
                setState(STATE_A);                                              // switch back to state A
#ifdef LOG_WARN_EVSE
                printf("\nError, communication error!");
#endif
                ResetBalancedStates();
            } else if (timeout) timeout--;
```

and I think this is the reason why I cannot enter bootloader mode. It says "bootloader not found". Screen always stays bright and each minute it gives error about temperature. So as far as I understand it thinks that there is a car connected and does not give opportunity to enter bootloader mode. What should I do now? I want to reprogram it back as it was... :(

gxnse, 2022-01-23:
I just can't enter bootloader now... :(

gxnse, 2022-01-23:
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

mstegen, 2022-01-24:
What is causing these temperature messages? Is it really that hot inside?

You can try this:
Make sure nothing is connected to 12 pin connector.
connect the FTDI cable to the SmartEVSE.
start the AN1310 (bootloader program) and press the break(pause) button (F3)
power up the SmartEVSE.

It should now enter the bootloader, if not you might need to reprogram it using a pickit.

gxnse, 2022-01-24:
It is not hot inside.

It does not enter bootloader. I guess I need pickit now. Is microchip is soldered there or I can just take it off?

mstegen, 2022-01-24:
Yes you can try it with a pickit, then you can program the complete pic, including the bootloader.
You can also send it back to me if you want, then i'll reprogram it for you.

gxnse, 2022-01-24:
You can email me on mainemail.exe@gmail.com

mstegen, 2022-01-31:
I'm also located in the netherlands, just send it to the address listed on www.stegen.com

Closed 2022-01-31.

Thread 33 (2022-01-28):

HW fix for LCD re-init?

zharijs, 2022-01-28:
Hi.
What's with the re-init of LCD at contactor open and close functions? Surely, this is a quick patch not a solution. I'm volunteering to fix the HW issue causing this to be needed, if someone can tell me how exactly to reproduce the LCD issue on my side. What contactor was used, what ware the load conditions, how long ware the wires?

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

mstegen, 2022-01-31:
Hi,
The re-init was added to fix garbled LCD screens. It sometimes happens with big contactors that are next to the SmartEVSE.
Even when there is no load connected to the contactor it sometimes garbles the LCD.
I've also seen it happen when the contactor switches a big 2 phase to one phase transformer on or off.

zharijs, 2022-04-19:
Hi.
Yup, that's what I thought, but I could not reproduce it.
Perhaps you have P/N for the contactor that caused it? I could order it then, add hardware fix and confirm that it would not happen anymore.

AndrejValand, 2022-05-25:
I also had some problems with display sometimes not working after contactor switch off/on. I have done extensive testing with an old nasty contactor. Below the HW+SW updates to make the whole LCD functionality much more robust. With this updates i could not bring the smart EVSE to have problems with the LCD anymore.

Hardware Modifications:
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

Needed Firmware modifications GLCD.c:
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

Needed Firmware modifications EVSE.c:
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

mstegen, 2022-05-27:
Hello Andrej,

Thanks for your suggestions, i'll most likely implement your changes in the next HW rev of the LCD board.

AndrejValand, 2022-05-29:
Sure, glad to be of help to the project. I have tested and you can also simulate the LCD corruption issue with the standard iskra contactor but using a much longer FPC cable and a moving the LCD board out of the SmartEVSE housing. I know its not a real situation, but it simulates the increased influence of external EMF on the LCD system of the SmartEVSE than can occur in some situations.

Thread 34 (2022-01-28):

Switch between single phase and 3 phase

martijndierckx, 2022-01-28:
In theory ... would it be possible to switch between single phase charging and 3 phase charging using 2 relays? Would it possible to control those 2 relays, instead of the default 1 using the current SmartEVSE2 hardware, by changing the firmware?

Let me elaborate:

I want to make my SmartEVSE even more smart by reading the battery status from the car (not via SmartEVSE, but directly using the cars' API). And based on that, calculate what the most ideal charging current would be.
Why? Because in Belgium you get charged based on the current peaks you cause on the network, so you benefit by keeping the charging current as low as possible.

The minimum charging current is always 6A:
- On a single phase: 6A x 230V x 1 = 1380W
- On three phases: 6A x 230V x 3 = 4140W
This could have a big impact on the monthly energy bill.

So if I calculate that 6A or 10A single phase charging would be enough to charge the car overnight, I would tell SmartEVSE to only use a single phase (over Modbus), which would then only switch on relay 1 controlling phase 1.
If I calculate that multiple phases are needed, I would again instruct SmartEVSE to do so, which would then switch on relay 1 for phase 1, and relay 2 for phase 2 and 3.

When switching between single and three phase charging, SmartEVSE would need to pause charging for a couple of seconds, because some vehicles might not handle the switch between single and multi phase charging well.

Your thoughts please...

fluppie, 2022-01-29:
Pretty good idea actually. A second contactor could provide this functionality. Or use 2 single phase contactors for 3 phase instead of 3phase contactors. Maybe a seperate microcontroller with modbus communication that controls this contactor? Then the SmartEVSE only needs a software update and not a HW revision.
Something like this https://webshop.domoticx.nl/index.php?route=product/product&product_id=1868 but with decent relays (I just would use another contactor)

mstegen, 2022-01-31:
Yes, two contactors to switch between 1/3 phase charging is a good idea.
My main idea was it to use it when solar charging. You start slow with only one phase, and once you get to 16A(or 18 A) on one phase, you switch to tree phases @ 6A.  But it could also be used for the situation in Belgium ofcourse (never thought about that!)
I think it's a bit difficult to add it to the SmartEVSE v2 code, as there are no unused IO pins anymore that can be used for this.

And you also need a way to disconnect the Control Pilot signal from the EV, so it thinks it's really unplugged.

Here's a picture of the SmartEVSE v3 prototype:
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

martijndierckx, 2022-01-31:
Nice!
ETA on v3?

mstegen, 2022-01-31:
They are being manufactured now. ETA is February.

WilfredHoogerbrugge, 2022-01-31:
I've been thinking about this too, nothing new actually the 'Zappi' already does this (and had some serious issues with the e-Niro and Kona, see: https://myenergi.com/zappi-2-firmware-version-3-033/ , scroll down for a full description of the problem)

Would it be an option to use the ouput for the motorized socket lock for the 2nd relais so owners of the current (v2) version can also use this featue? Ofcouse this only works when no lock needs to be controlled, like in my situations where a fixed cable is used.

mstegen, 2022-01-31:
Using the lock output to drive a (solid state) relay, which in turn then can switch the relay on/off could work. But you still need a way to isolate the CP signal. A second relay between 12V and the second output might be used for this. As long as the coils don't draw to much current it could work.

prjh, 2022-02-02:
That are interesting good news. An by the way I saw an USB-C socket on your prototype picture.
... conform to upcoming EU regulations :-)
THX

Thread 35 (2022-02-05):

Smart charging not working as expected due to latency

poelie83, 2022-02-05:
Hi all,

After charging for some while I started checking the system in Smart mode.
I have the SmarEVSE-2 and sensorbox 2 connected with 20m Cat6 cable, the sensorbox uses the P1 port to receive data.
The Green status led is blinking every 2 seconds when data has been received.
All above looks fine, until the load balancing needs to kick in.

The update rate from the sensorbox to the SmartEvSe-2 is way to slow. measured latency from disconnecting or connecting load is almost 10 seconds!! Due to this latency the SmartEVSE-2 is not throttling the output correct en go's to wait for power mode.

To make sure the update rate is fine I checked the RAW data with domoticz and a USB P1 logger, the update rate is 1 second.
Any ideas to fix latency issue?

mstegen, 2022-02-06:
Hi,
This should not happen, Every 2 seconds the SmartEVSE will receive a measurement from the Sensorbox, and if one of the phases is measuring above the Mains current (usually 25A in NL) it will immediately lower the charge current of the EV.
The measured phase currents are always visible on the LCD of the SmartEVSE.

You can check if everything is working correctly by switching on/off a load, and observing the values on the display.
They should change with a delay of max 2 secs.

The reason for different behavior could be a non compliant Smart Meter. I observed this when they installed a Landis+Gyr ZMF110CCtFs2
This smart meter does send a P1 message every second, but the data (except for the timestamp) will not change for 10 seconds!!

poelie83, 2022-02-06:
After your message I started to do some more research, I also live in the Netherlands, main fuse 3x 25A, the smart meter is a Landis+Gyr E350 with DSMR 5.0. update rate 1 second with exact the same behavior as described above.
The smart meters sends a P1 message every second but the data is only updated every 10 seconds :-(

Is it possible to add some Landis+Gyr support in you product? instead of scaling down every 2 sec to a lower power mode I suggest to go to the lowest power mode and step up every 10 sec until the 25A has been reached? this is the safest way to prevent fuse blow out. it would be sad to add three current measure clamps to resolve the meter issue.

Thanks for the quick reply!

mstegen, 2022-02-06:
Ah, yes the E350 is unfortunately not supported. Weird that it works, i have never seen a E350 with a (D)SMR 5 telegram.

For what it's worth, i told the 'netbeheerder' that the installed meter is not DSMR 5.x compliant, and they exchanged it for a Iskra AM550-TD2, at no extra cost.

The SmartEVSE code requires a accurate measurement every two seconds, it's not easy to add code changes that change this to 10 seconds, and imho 10 seconds is too long if there is a sudden power increase.

poelie83, 2022-02-07:
I will try to contact the netbeheerder first :-)

please see the photo attached with the SMR 5 value on it, thanks for the quick reply! love your work.

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

mstegen, 2022-02-07:
It's the same as the one i once had. The ZMF110CCtFs2 model, look at the top left corner..

poelie83, 2022-02-10:
22th of February the "Netbeheerder" will swap the meter :-) I will post an update after the swap.

IgorYbema, 2022-02-10:
Anyway, the fuse will not blow up that fast. It can take that more load for a few seconds or even minutes. So this 10 second delay, although weird, is no problem. DSMR4 meters update each 10 seconds also and you wont see blown fuses there.

mstegen, 2022-02-10:
@poelie83 Great news!
@IgorYbema It would require some code changes to the SmartEVSE software, in order to make this work on this smart meter. The SmartEVSE will increase/decrease the chargecurrent every 2 seconds. If it measures for example 27A at one phase, and the max MAINS setting is 25A, it will lower the chargecurrent to the EV with 2A.
With this L+G meter it would lower the chargecurrent over a period of 10 seconds, 5 times with 2A. so in total 10A.
Obviously this will not work correctly.

IgorYbema, 2022-02-11:
Ok I get it now. And forgot smartevse doesn't support DSMR4 :)
Although 10 secs would still be ok for most fuses I rather would keep it on 2 secs too :)

Thread 36 (2022-02-07):

SmartEVSE not recognising car anymore

RIOuShil, 2022-02-07:
Probably hardware issue, not software issue. But want to rule out software before swapping hardware out.
SmartEVSE was always working without issues. Great product. I have 2 in load balancing mode. And an ESP8266 connected to the smart meter and my kwh meters. ESP8266 runs modified sensorbox code to provide the EVSEs with the current numbers and update my smarthome system with readings.

Recently 1 of them started malfunctioning. I plug the EV in, but EVSE does nothing. Sometimes the LED screen will light up, sometimes not.
Most of the time it worked again after turning the EVSE on and off. But even that is now no longer working.
If I put the multimeter on CP and GND, it sometimes shows around 9V, sometimes more around 6V. If I then turn EVSE on and off, it works mostly. Putting the multimeter on there, somehow makes it sometimes work after turning EVSE on and off.
If EVSE turns to smart charging, it typically stays active for quite a while. It might drop every once in a while for unexplained reasons (ie enough power available), but then usually picks it back up again soon

So my guess is a hardwire issue on GND or on CP. Before these problems started, I had quite some unexpected serial comms issues, which went away when I simply disconnected GND. I have the 2 EVSE in load balance.

Any thoughts on how to fix welcome. I might swap the 2 EVSEs to confirm it is really the EVSE (and not the fixed cable connected to it), but have not had time to do this yet and would rather not if I did not have to

mstegen, 2022-02-07:
Hi,
Could you please let me know the software version the SmartEVSE's are running?

When there is noting connected to the CP pin, it should measure +12V. When a car is connected, it's no longer possible to measure it with a multimeter as it will vary between +9V/+6V and -12V at 1000 times a second.

RIOuShil, 2022-02-07:
Hi!
I'm on 2.13.1. Was always working well, so did not need to update (and if I update now I would need to adjust my ESP8266 code, because the Modbus addresses changed I believe)

Indeed, 12V, 0Hz, when nothing correct. I get 9V 1000Hz when cable is connected, but nothing happening. 6V 1000Hz when charging (I think, cannot get it to charge now).

Tx for your help!

p.s. If I need to get a new unit, then totally fine. It has worked reliably for long time and it is a great product that I highly recommend :)

fluppie, 2022-02-07:
@RIOuShil would you care to share your ESP8266 code, since a lot of people try to get this functionality :-).
I assume all modbus meters are connected to the SmartEVSE and you kinda read them out in parallel or by sniffing the RTU modbus line?

RIOuShil, 2022-02-08:
Sure @fluppie. I'll see if I have time over the weekend. But honestly, I'm a really bad coder. Fully self taught. So my code is very very crappy. Specifically the bit bashing of Modbus was quite a challenge for me. But, it works for me now, so happy to share (but with a big disclaimer). I do think it would be wise for @mstegen to release his upgraded sensorbox, with for sure much better code :)

mstegen, 2022-02-08:
When at +9V/-12V 1kHz, the EV should detect the signal, and initiate the charge by pulling it to 6V.
Have you checked the charge cable/plug for water ingress?

Ofcourse i can always check the smartevse for you on my test bench. Just send it back to me. I'll check/repair it if needed.

RIOuShil, 2022-02-08:
tx. Let me do some more tests first indeed. Easy would be to swap the 2 EVSEs. That would rule out the cable as issue. If cable is the issue, it is probably the plug I guess? Do not really think water could get into the cable itself. I tried opening the plug before, but could not fully reach all the torque screws and it seemed rather well build, so was kind of assuming water would not get in. But I can buy some longer torque screwdrivers and have another go for sure. tx for the help!

IgorYbema, 2022-02-10:
> @RIOuShil would you care to share your ESP8266 code, since a lot of people try to get this functionality :-). I assume all modbus meters are connected to the SmartEVSE and you kinda read them out in parallel or by sniffing the RTU modbus line?

@mstegen released the esp32 sensorbox code today. So you can add to that for your own monitoring purpose

RIOuShil, 2022-02-15:
Quick update: It is probably water ingress in the charger. I have one with a button on top to open the chargeport. Button should be waterproof. However, the PP to Earth resistance should be 220 ohms, but when measured is way too high and all over the place. Contacted the vendor and they are sending a replacement. Useful guide here (outlines how to measure resistance, etc.):
https://www.evchargeking.com/Media/Uploaded/Tesla%20Connector%20Installation%20Instructions.pdf

Thread 39 (2022-02-27):

Solar charging stability

mintgroen, 2022-02-27:
I noticed possible undesirable behaviour of the available current calculation.

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

My Hyundai Kona connected and the SmartEVSE set to smart charging, with max 6A import set and timer at 60min. Solar panels on phase 1 and 3 are happily producing and solar charging started a 4A export.

At 10:47 you see the variation in power drawn on all phases starting. Looking at the SmartEVSE display, I saw the available current flipping from 7A, to 6A (timer started) and back to 7A again and flipping to 6A again.

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

At 10:52, I've manually changed the import to 5A to stop the switching.

Is this behaviour intended and ok? Or should there be a stabilising functionality that avoids the switching back and fort every 10 seconds?

mintgroen, 2022-02-27:
After some minutes, the value started flipping again. I've set the max import back to 6A at 11:09, variation increases.

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

Why does this happen?

mstegen, 2022-02-27:
It could be that the car is cold, and that it tries to pre-heat the battery.
On my model S i see something similar. When cold, it keeps switching between 6-8A, and after 30 minutes or so, it stabilizes and starts charging normally.
The SmartEVSE will vary the charging current in 0.1A steps, maybe the Kona accepts only steps of 1A (just a wild guess here)

mintgroen, 2022-02-27:
It's the EVSE that is throttling back and forth:

https://photos.app.goo.gl/iqvHoNuMvBxxS5LX7

But why?

Setting the import to 0A make the current stable again.

bobosch, 2022-02-28:
Do you use modbus to get the measurements for the nice graph? Maybe to many collisions

mintgroen, 2022-02-28:
The measurements are p1 telegrams, the same as the sensorbox receives. (Which is blinking green)

mstegen, 2022-03-01:
I checked your video, the EV is not responding quick enough to the current set by the EVSE (or the SmartEVSE is increasing the current too fast)
Software version 2.3 increases the current with max 0.5A per 2 seconds, when solar charging. This should help stabilize the set current.
Ideally it should depend on if you are charging on 1 or 3 phases, but this is not implemented yet.

https://github.com/SmartEVSE/SmartEVSE-2/releases/tag/version_2.30
If you do not have a programming cable to update the controller to version 2.30, you can send it to me for reprogramming.

Thread 40 (2022-03-10):

Unable to read modbus on V3

k-janssens, 2022-03-10:
I've installed the latest V3 yesterday and the hardware is working great.
Only problem I currently have is to read the modbus registers.

Regardless if what register I try to read, I always get the exact same response:
`21:04:19:482 > 00 49 00 00 00 06 01 03 00 02 00 01
21:04:20:509 < 00 49 00 00 00 06 0A 04 00 00 00 14
21:10:18:578 > 00 4A 00 00 00 06 01 03 00 04 00 01
21:10:20:513 < 00 4A 00 00 00 06 0A 04 00 00 00 14
21:10:47:492 > 00 4B 00 00 00 06 01 03 00 0A 00 01
21:10:48:516 < 00 4B 00 00 00 06 0A 04 00 00 00 14
21:10:52:844 > 00 4C 00 00 00 06 00 03 00 02 00 01
21:10:54:510 < 00 4C 00 00 00 06 0A 04 00 00 00 14 `

Besides the response always being exactly the same, the value '0A 04 00 00 00 14' can be found on the Sensorbox documentation (see the example below the page):
https://github.com/SmartEVSE/Sensorbox-2

So am I doing something wrong? Or is the modbus implementation changed in V3?

Additional info:
- tried both modbus and modbus rtu
- sensorbox is connected with the P1 of my digital meter
- no kWh meter
- I use a waveshare device to read modbus over tcp

mstegen, 2022-03-10:
Modbus implementation has changed. For v3 i'm using the eModbus library (https://github.com/eModbus/eModbus) which works different from the implementation from v2.
But it works fine as master or as node controlled by a master, also mixed with older v2 controllers, but i have not tried to control it from a external modbus controller.

I'm trying to understand what response you are receiving, but i can not make any sense of it yet.. All i know is that a modbus message should not start with '00'
The SmartEVSE uses modbus RTU @9600 bps 8N1
Maybe you should try to listen to the modbus data first, you should be able to receive measurement data from the sensorbox every two seconds.

k-janssens, 2022-03-10:
I'm using the same hardware as a friend of mine uses with the V2.
Got all his settings and such, but if he makes a request he is getting the proper response but I always get the same response: 00 00 00 00 00 06 0A 04 00 00 00 14

No matter which register I try to call or any other setting.
A few screenshots from the client I'm using:

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

In the Waveshare interface this is the data he is receiving every second (which make sense as the sensorbox is working as it should):
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

kennyschuoler, 2022-03-11:
I just replaced my v2 controllers with the new v3 controllers, and i have the same issue, i'm unable to connect to modbus anymore.
I also tried if we could directly connect to modbus via the wifi interface, but it seems this is not (yet) available ? ( It's also possible that it is not the default 502 port, but here i'm waiting for the source code to figure this out )

9600, 2022-03-11:
@mstegen You called?

kennyschuoler, 2022-03-11:
> @mstegen You called?

It was on accident ... He mentionned the bitrate to connect to modbus, you can ignore this ;p

mstegen, 2022-03-11:
Two modbus masters do not (currently) work on v3, this is mainly because the eModbus library does only support two modes, master or node/slave. When configured for master, there is no modbus address set
There is also an option for a TCP bridge, but i have not used that yet.
My main focus was to get communication from the master controller to nodes/ kwh meters and sensorbox to work.

Thread 42 (2022-03-30):

"Bootloader not found" revisited

cvanlith, 2022-03-30:
Just received a new sensorbox2 but couldn't get it to communicate. Therefore I tried to upgrade the software from 2.04 to 2.30. Unfortunately I get "Bootloader not found" when I try to connect  to the SmartEVSE module using a FTDI cable and an1310ui.exe. Normal CLI works.

I tried the suggestion from @mstegen:
* Make sure nothing is connected to 12 pin connector.
* connect the FTDI cable to the SmartEVSE.
* start the AN1310 (bootloader program) and press the break(pause) button (F3)
* power up the SmartEVSE.

But this also fails.
I never upgraded the unit before. What to do?

mstegen, 2022-03-30:
Is the FTDI cable connected the right way? The black wire should be on the side where it says 'BLK' on the circuit board.
Also make sure the correct COM port is selected in the setup of the AN1310 bootloader program.

If it still does not work, please send it back and i will reprogram it for you.

-Michael

cvanlith, 2022-03-31:
OK, I will order a new one and send the old one back after I have installed the new one. I need to charge my car :-)

Closed 2022-03-31.

Thread 43 (2022-05-02):

Implementing a clock and schedule for minimum morning charge when in Solar mode.

scspijker, 2022-05-02:
### Description
Context: My car has a very large range (400km) and I only need about 80% (60kWh) per week to remain full.

I like the solar mode on SmartEVSE, only charging solar, I've though of a further improvement though.

Currently I just leave it in Solar mode all the time, and plug in everytime I park the car. This usually fills up the car (limited to 80%) to more than I need. Sometimes however, we have little sun for a lot of days, and my charge creeps down to 15%. Then I need to manually tell the charger to charge from grid, however, usually I think of this too late. I'd like to wake up in the morning to a minimum charge of 40%.

I think implementing a clock, and a rudimentary schedule would solve this issue. For example:

Set to solar mode
Set minimum morning charge level to xx%
Set minimum morning charge start time: 02:00 (after sundown, guaranteed in my place of residence).

Say the sun doesn't provide enough power to get my car up and over 40%, the SmartEVSE will start charging at 02:00 from grid power up to xx%, and then stop (unless solar power is available again).

This will make solar mode much more attractive during periods of low sun.

### TL;dr

SmartEVSE in solar only mode.
Sun does not shine enough, car not charged above 40%.
SmartEVSE will start charging using grid power at night until 40% has been reached.

scspijker, 2022-05-02:
I'm an programmer myself (originally embedded), and am looking to buy a new charger. Do you think it would be possible for the SmartEVSE to implement a clock, and this schedule charging?

If so, I might buy a V3 and open up some pull requests 😁

hyperbart, 2022-05-04:
This can be handled by using EVCC:
https://github.com/evcc-io/evcc
--> https://github.com/SmartEVSE/SmartEVSE-2/issues/44

scspijker, 2024-02-28:
This may be possible with new OCCP 2.0 standards

zharijs, 2024-03-24:
Throwing out some ideas -

1. I'm looking into implement OCCP in ESP - it's not trivial but seems possible. It would not help much with getting car data though, unless you have some connection from car to manufacturer and manufacturer would share the data through OCCP on internet.

OCCP is is more for controlling, configuring and "multiboxing" the charger network.

2. Also I'm looking in to possibility of implementing PLC (as in power line communications not programmable logic controller) to read the charge state and vehicle statuses form vehicle directly.

You need a special hardware for that. Interface chip / module manufacturers are quite secretive about it but there are some modules available it seems. One I red a bit about was bridging PLC to UART. So ESP debug serial multiplexed by minimal glue logic, switched by USB voltage (I've done that with single SOT23-6 package for ESP8266 before) could be used to talk to it.

If anyone is interested in participation getting this implemented, I can share more of my findings in the field.

3. About the schedule (RTC) - it should be simple fairly simple to implement system clock based RTC with periodic interrupts that would be set and corrected ever so often by NTP. Again - done that on 8266 before. The painful part would be to make the actual interface to configure the thing.

4. Would it not be better to get the "charge authority" by reading/scraping Nordpool instead of preset RTC if you have your rate tied to exchange?

Thread 44 (2022-05-04):

Enable or facilitate support for EVCC

hyperbart, 2022-05-04:
It would be nice if SmartEVSE could be made compatible with https://github.com/evcc-io/evcc .

EVCC would act as a charge controller so you don't have to put clamps in and it does this by combining all metered devices (solar inverters, digital meters etc) and combine this with the SoC of a car to efficiently charge one or multiple cars.

hyperbart, 2022-05-04:
Duplicate, this issue should have been posted at V3.

Thread 45 (2022-07-27):

Renault ZOE ZE50 start of charge problems on hot days

AndrejValand, 2022-07-27:
Hi,

I'm having problems with my ZOE in this hot days. When it enters the state C with the preset max current the car interrupts the charging to start up its heat pump assisted battery/charger air cooling system. SmartEVSE goes into a wait mode the car start up the cooling but depending on temperature it shuts it cooling off before the charging is started so this sometimes goes on and on... Charge start/stop/restart...

I found that if charging starts with the minimum preset current and waits a few seconds so the car can start all its internal cooling system than i ramp up the charging current all works well. It goes normal to full charging power without any issues. Slow ramp up of charging current is also beneficial for regulation and fuse safety in a home. In an overcurrent situation the current is reduced instantly but than it ramps up slowly again.

I made this changes to the code and i'm testing this now:
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

There is maybe some other more correct/elegant way of doing this, and i have no way to test this in a solar situation, but this slow current ramp up can be beneficial also for solar setups.

I also noticed that some better public chargers perform a slow charge current ramp up.

Any ideas and comments welcome.

Regards, Andrej

bobosch, 2022-07-28:
Please check out the latest git version. Two features where added recently that may solve this issue, too:
- At solar charging charge at least 40 seconds at minimum current (https://github.com/SmartEVSE/SmartEVSE-2/commit/0890c6872419c7850775f022a8d8cf7788768683)
- Avoid increasing current while charging at minimum current https://github.com/SmartEVSE/SmartEVSE-2/blob/901012e0d9319b2277556e6a8c6c9071016e9b1e/SmartEVSE2.X/EVSE.c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

AndrejValand, 2022-07-28:
Ok will test this, but need to wait until its over 35°C again and have the car a few hours in the sun:) Tried today a few times as it was 27°C and the car did not even start the cooling until over 20min into the charging session and even then only the fan without the heat pump. In this normal situation it does not stop the charging to do this. Its interesting how this 8°C makes such a difference how the car works with its cooling system. But yes if the charging in this last version starts at minimum current and waits a few seconds, so the cooling system can engage,  than goes to max set current or whatever is available it should work.

Will report back when i can test this last release on a hot day. Must i set the SmartEVSE to Solar mode? Will this test ok  without the solar installation? I use Smart mode now.

I also went today to a  few public charging stations in vicinity and all take quite some time before full charging is engaged 10-20s. Don't know it they are negotiating so long or are they starting with a low current then switching to full. Definitely one i tested i can hear it ramps up the CP current slowly (Renault Caméléon® charger you can hear as it used the motor for power conversion).

bobosch, 2022-07-29:
The "slow start" is only active on Solar mode, because there it's most likely that the car can only charge with a low current.

At Smart charging more current should be available. What is your Max current setting?

The ZOE uses 3 phases, up to 32 A, so 22 kW charging capacity. Maybe the heat pump cools the battery to allow faster charging only when a certain power level is available. Could you please describe the issue with some power levels or take a film from the SmartEVSE display? What do you mean by "wait mode"? On Solar charging with bad configuration (e. g. START 1 A and STOP 1 min) it will also switch on and off every minute when not enough current is available. On Smart charging it depends on your installation - how much capacity is available?

AndrejValand, 2022-07-29:
I have 20A main fuses in our house, and have 16A max current set for charging, 6A as the min current. Even if i set max current to 8A and if its really hot outside the ZOE ZE50 i have will not initiate charging with the SmartEVSE the first time. The only start current that it accepts in this situation not to disengage charging to start up its internal cooling procedure is 6A.

Initial condition is there is more than 16A available from the house, outside its 30°C+++ the car is in the sun. Smart charging is enabled. With 35°C outside this happens always (last week).
What happens:
-I connect the car, negotiating begins
-SmartEVSE sets the current to 16A the car wants to start the charge, but it disconnects in a second. I can hear the heatpump starting up.
-SmartEVSE is waiting for a while, the car internal cooling is wining up to operation. In best situation the SmartEVSE restarts charging while the cooling is still active and the charging starts normally the second time. Sometimes the car internal cooling is not on long enough and switches of when SmartEVSE restart the charging procedure, so again the car disconnects the charging and starts up its internal cooling. This can go on for a while sometimes, depending on temperature, SmartEVSE contactor on/off cars internal heatpump on/off...

What i tested:
-I first set the maximum charging current to 6A on the SmartEVSE, and it worked without problems, engaging the charging the first time always even at this hot temperatures.
-Then i manually went into the SmartEVSE menu and increased the max charge current slowly to 16A and the car normally started the cooling and continued the charging procedure without interrupting it.
-I did not test what happens if i start the charge at 6A and then after say 10s  change it immediately to 16A.
-I tried some public AC charging stations and they worked even at this high temperatures the first time
-Next i added the code i posted above and it was also working fine with SmartEVSE (starting at 6A, waiting a bit than ramping up to full current). But as current is changed and calculated at few places in code i'm not 100% certain the solution is 100% compatible for solar and multi SmartEVSE solutions.

I can make a video next time, for sure there will be this extreme hot days in august.

In the solar charge situation slowly ramping up the current could maybe also reduce on/off situations, but i don't have a solar installation to test this. Also i don't know if some other cars could have a problem if charging is started with 6A and then ramped up to full, but i think not.

bobosch, 2022-07-29:
Solar mode won't work without PV ...

I've created a patch to enable the change also in Smart mode and changed the Phase detection to start 10 seconds with 6 A charging. Please apply it and check with this version. After 40 seconds it will try to detect the number of phases used by changing the current between 6 A and 8 A, after this the current will increased.
[delay.diff.txt](https://github.com/SmartEVSE/SmartEVSE-2/files/9218210/delay.diff.txt)

AndrejValand, 2022-08-14:
Hi,

There still was no day that was over 35°C++ in the last two weeks so i made three videos in the mean time:
 - SMART charge with phase detection charge engagement
 - SMART charge with current ramp up
 -  Standard SMART charge charge engagement

As it way "only" around 30°C max no issues with charging but still  the cooling behavior of the ZOE can be observed.

Else I find the phase detection feature brillant. Its useful to see with how many phases the car charges. It would be nice to have this included standard in smart charging, but there is one think i don't like as the SmartEVSE alternates the current between 6/8A again ZOE starts/stops the Heat pump for battery/charger cooling. It does not interrupt the charging but its not nice to hear as you can see from the video. I was thinking the charging phases detection algorithm could also use the slow ramp up current to detect how many phases are active without cycling between 6/8A. This could provide more "smooth" charging experience. What do you think?

Car cooling in the background while using Phase detect algorithm:
https://user-images.githubusercontent.com/78184229/184541944-6a53eb86-9eac-4fe3-a3c8-23942fc3e50b.mp4

Car/SmartEVSE while using ramp current startup:
https://user-images.githubusercontent.com/78184229/184542026-91f7c82b-9fa8-4975-9014-b78b140e7d4b.mp4

Car/SmartEVSE while using normal V2.30 charge startup:
https://user-images.githubusercontent.com/78184229/184542125-a479e345-3ac7-4f27-ad6c-e1c740101985.mp4

Will try to leave the car in the sun the whole day and next week as we have some 33°C prediction i hope i can than also make the video of the initial problem. A shame i did not think on recording a video back that when we had this heat wave for two weeks and i had problems every day i was charging...

bobosch, 2022-08-18:
Hi, great thanks for the feedback!

The car have to react to a decreasing current faster than to an increasing current.
To avoid interference with other electricity consumer I only use the decreasing to detect the phase.

In the startup some cars take more than half a minute until they draw the full current, and my car immediately starts charging...

I will try to monitor the current on startup, count the number of phases raising about 6 A and verify with one cycle between 8 A and  6 A

bobosch, 2022-08-19:
[EVSE.zip](https://github.com/SmartEVSE/SmartEVSE-2/files/9381736/EVSE.zip)
This version tries to detect the charging start (0 -> 6 A), and verifies to measurement by increasing from 6 A -> 8 A. Only when this fails, it cycles between 8 A and 6 A. Please give it a try.

AndrejValand, 2022-08-20:
Thanks Robert. Will try this today and report back.

In the mean time below the videos from two days back when it was 35°C so the CAR started to interrupt the charging, but it was a bit different as when it was 38°C++ for a week and i had the most problems... Now it interrupted the charging at 8A not immediately at 6A, also there was always only one charging restart then it continued to charge normally with all three possible start-up procedures i tried.

What i learned from this is that even ramping up the current slowly does not help in all situations with the ZOE. And there is no way around it that it sometimes disables the charging to start up its cooling at charging start. The main problem i was having where it restarted charging  a few times before it started charging normally, i think now is a timing issue with the ZOE in this special situation in combination with SmartEVSE. SmartEVSE waits quite some time to restart charging. If the car interrupts the charge and in this time the completely shuts down it cooling, when SmartEVSE restarts it started cycling Charge/Restart... Can you please point me to where this time is set in the code i will try to shorten it a bit maybe for 2-5 seconds and i think the problem will be solved. Than it should do only one restart as in vides below in all temperature situations.

Phase detect startup @35°C with one restart:
https://user-images.githubusercontent.com/78184229/185737575-14ba96c9-4456-496e-b820-a33810dde770.MP4

Current Ramp up startup @35°C with one restart:
https://user-images.githubusercontent.com/78184229/185737681-4e5de857-bc45-42c2-be21-8cdc177d3370.mp4

Standard full current start  @35°C with one restart:
https://user-images.githubusercontent.com/78184229/185737701-fefa5858-b872-4177-aead-44ae8e152a0a.mp4

AndrejValand, 2022-08-20:
Was unable to test as its raining like crazy, but did try inside with a simulator. There is one bug if you disconnect charging where DETECTING is on screen it stays on the LCD even when car is disconnected.
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

AndrejValand, 2022-08-20:
Rain stopped and i could make some tests with a real car and it has some problems. The current looks ok but it seams to detect false active phases number now.

Try1..3,5:
https://user-images.githubusercontent.com/78184229/185762051-d9f63067-55cd-44f7-bd01-d07cf365cfaa.mp4

Try4:
https://user-images.githubusercontent.com/78184229/185762055-ab074573-b65f-447b-b485-6f7ea0e2637f.mp4

AndrejValand, 2022-08-22:
Was thinking over the weekend. Will phase count detection work ok also in load balancing systems?

bobosch, 2022-08-24:
Untested now. The idea is to pause balancing when measuring.
I fixed the bug, added two constants and changed number of identical measurements from 2 to 3...

#define STARTCURRENT_MEASURE_INCREASE  // Count phases on decreasing and increasing current
#define STARTCURRENT_IDENTICAL_MEASUREMENTS 3 // Number of identical measurements

[EVSE.zip](https://github.com/SmartEVSE/SmartEVSE-2/files/9414792/EVSE.zip)

AndrejValand, 2022-08-24:
The DETECT massage problem is gone. But still i have prolonged reaction time from C->B during the detection phase. This causes the vehicle to enter charger error state. The max reaction for C->B time must be below 100ms this is per EN61851 standard also. This was also my initial problem with the SmartEVSE an the ZOE a few years back, after this reaction time got fixed it worked always. And for unknown reason after a while the power is not updated anymore from the EV meter. It stays at some old value even if charging current changes. The kWh increases normally. Strange.

AndrejValand, 2022-08-24:
Just tested the version from a few week's back (901012e0d9319b2277556e6a8c6c9071016e9b1e  from 19.7.2022) i had downloaded from the repository and there are no problems with C->B detection reaction time. Also power is always displayed correctly when using an additional EV meter. The version had some beginnings for phase detection but probably only for solar. Hope this helps to identify the bug.

Thread 46 (2022-08-20):

RCM error screen stuck at "PRESS BUTTON TO RESET"

AndrejValand, 2022-08-20:
Was playing today a bit with SmartEVSE and there is a small issue with RCM error display. But the issue is only cosmeticall with an easy improvement.

When RCM error is detected a massage is shown that toggles between "RESIDUAL FAULT CURRENT DETECTED" and "PRESS BUTTON TO RESET". No error is displayed over CLI.

When the user presses the button while "PRESS BUTTON TO RESET" massage is displayed, the next time the RCM error is detected there will be "PRESS BUTTON TO RESET" massage displayed and not "RESIDUAL FAULT CURRENT DETECTED" if the detected fault is present for a long period of time.

I made two modifications that improve the RCM trip situation:

GLCD.c
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

EVSE.c
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

Thread 47 (2022-09-12):

What is the purpose of the LED at ping +12V and LED

Elektrofix-OL, 2022-09-12:
I have updated my smartEVSE V2.02 to version 2.30 because I want to use the solar function.
Between +12V ==> I/O1 (LED) I have an LED and between I/O2 (sw) ==> GND I have switched the button.
I can't figure out how the LED works, it's always on, regardless of whether I'm charging solar, smart or normal.
The button works perfectly.

Greetings from Oldenburg (Odlb)

Ps: sorry, translate whit google.

mstegen, 2022-09-13:
Then you probably have an older SmartEVSE hardware revision. If it says 1 instead of LED on the circuit board, then there is no mosfet on this output pin.
You can add a general purpose N-channel mosfet to this output pin, which then can drive the LED correctly.
I used a BSS138 on the SmartESVE v2.2

Connect the gate to the output pin, and the source to GND. you can connect the drain to the LED.

Closed 2024-03-31.

Thread 50 (2023-04-22):

Loading hex file from Linux

lhupfeldt, 2023-04-22:
I'm on Linux.
I have compiled the project and now I need to load it.

The instructions here https://www.smartevse.nl/building-and-programming say "Start the AN1310 bootloader program in the /bootloader directory."
I cannot find any program  called AN1310, and no bootloader directories related to mplab.

Should I use UnifiedHost-1.19.1 booloader from here https://www.microchip.com/en-us/tools-resources/develop/libraries/microchip-bootloaders/8-bit?
If so, then what are the correct settings?

Or something completely different?

bobosch, 2023-04-22:
Hi, I use Linux, too.
Good questions, some years ago it was available. It runs fine on wine :-)
Regarding this document https://ww1.microchip.com/downloads/en/AppNotes/01310a.pdf
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
even the source code was free to download, also available here https://github.com/martonmiklos/AN1310-Qt5
So I think it is OK to share the original archive with the windows executable here
[Serial Bootloader AN1310 v1.05r.zip](https://github.com/SmartEVSE/SmartEVSE-2/files/11301779/Serial.Bootloader.AN1310.v1.05r.zip)

lhupfeldt, 2023-04-22:
Hi @bobosch,

Thank you for your quick reply. I would rather not have to install wine just for this if there is a simpler solution.

UnifiedHosts did not work with java 17, I changed to 1.8 and then it started

`sudo alternatives --config java`

select `java-1.8...`

`...UnifiedHost-1.19.1]$ java -Djava.util.logging.config.file=logging.properties -jar UnifiedHost-1.19.1.jar `

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

I have not tried using it, as I don't know which options to select.

mstegen, 2023-04-25:
The Unified Bootloader is unfortunately not compatible with the AN1310 bootloader, so this will not work.
I think the only option right now is to compile the sourcefiles somehow, or run wine.

The windows bootloader can be found here:
https://github.com/SmartEVSE/smartevse/tree/master/bootloader

lhupfeldt, 2023-05-21:
Thank you both for your replies.
I finally got around to this again, and would like to provide some information if other people that may attempt loading firmware from Linux.

I could not make the AN1310 application running under `wine` recognise the usb serial port. It shows up correctly in linux as `/dev/ttyUSB0` when the cable is plugged into the laptop, and it shows up automatically in `.wine/dosdevices` as com33 and com34. I also tried symlinking it to com1. I have `rw` permissions to the device (I added myself to the `dialout` group). However the AN1310 is not showing the serial USB device.

I have instead compiled the program for Qt5 from the sources mentioned above, and the usb device is showing up (I have not yet attempted to load the hex file onto SmartEVSE).
The compilation was rather complicated, the instructions in the Readme.txt were insufficient.

Follow steps 1-3 from the Readme.txt (or replace step 1 with installation of `QT Creator` using your package manager)
Before step 4 (compiling  AN1310ui/AN1310ui.pro) I had to add `Bootload` and `QextSerialPort` as external libraries, as described here https://doc.qt.io/qtcreator/creator-project-qmake-libraries.html. Add the archive files (.a) from the build-Bootload/QextSerialPort-Desktop-Release and add the include dir as `Bootload/QextSerialPort` respectively.

lhupfeldt, 2023-05-21:
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

bobosch, 2023-05-22:
With wine you have to add a registry key (wine regedit) to
Path: HKEY_LOCAL_MACHINE\Software\Wine\Ports
Name: COM1
Type: REG_SZ
Value: /dev/ttyUSB0

lhupfeldt, 2023-05-22:
I actually tried that as well, forgot to mention that. Unfortunately I already uninstalled wine after building the native Linux AN1310 application, so I can't double check that I entered exactly what you suggest.

lhupfeldt, 2023-06-25:
For anybody coming here:
The https://github.com/SmartEVSE/SmartEVSE-2/files/11301779/Serial.Bootloader.AN1310.v1.05r.zip does NOT work. It goes into an endless flashing loop, as described here https://github.com/martonmiklos/AN1310-Qt5/issues/2. This https://github.com/MrFillbert/AN1310-v1.05-QSerialPort works.

Thread 52 (2023-05-21):

Cannot open include file error

lhupfeldt, 2023-05-21:
I'm attempting to build the project using MPLAB X IDE 6.10, but I'm getting the followng error:

```

EVSE.c:3103:86: warning: (373) implicit signed to unsigned conversion
"/opt/microchip/xc8/v2.41/bin/xc8-cc"  -mcpu=18F26K22 -Wl,-Map=dist/default/production/SmartEVSE2.X.production.map  -DXPRJ_default=default  -Wl,--defsym=__MPLAB_BUILD=1   -mdfp="/home/lhn/.mchp_packs/Microchip/PIC18F-K_DFP/1.1.58/xc8"  -fno-short-double -fno-short-float -memi=wordwrite -mrom=0-FCFB -O3 -maddrqual=ignore -xassembler-with-cpp -mwarn=-3 -Wa,-a -msummary=-psect,-class,+mem,-hex,-file  -ginhx32 -Wl,--data-init -mno-keep-startup -mno-download -mdefault-config-bits -std=c90 -gdwarf-3 -mstack=compiled:auto:auto:auto      -Wl,--memorysummary,dist/default/production/memoryfile.xml -o dist/default/production/SmartEVSE2.X.production.elf  build/default/production/EVSE.p1 build/default/production/GLCD.p1 build/default/production/bootloader.p1 build/default/production/utils.p1 build/default/production/modbus.p1 build/default/production/OneWire.p1 build/default/production/font2.p1 build/default/production/font.p1
::: advisory: (2051) the current license does not permit the selected optimization level, using optimization level 2
Non line specific message::: advisory: (1492) using updated 32-bit floating-point libraries; improved accuracy might increase code size
modbus.c:765:: warning: (765) degenerate unsigned comparison
/tmp/xcXLCGDGG/driver_tmp_1.s:8:: error: (140) can't open include file "/home/lhn/.mchp_packs/Microchip/PIC18F-K_DFP/1.1.58/xc8/pic/include/proc/18f26k22.cgen.inc": No such file or directory
/tmp/xcXLCGDGG/driver_tmp_1.s:29758:: error: (800) undefined symbol "tblptrl"
/tmp/xcXLCGDGG/driver_tmp_1.s:29760:: error: (800) undefined symbol "tblptrh"
...
```

The pack is installed:
```
 ls -d .mchp_packs/Microchip/PIC18F-K_DFP/1.1.58/xc8/pic/include/
.mchp_packs/Microchip/PIC18F-K_DFP/1.1.58/xc8/pic/include/
```
but there is no `proc` in the `include` dir

I have tried reinstalling the pack, but still no `proc`.

I successfully built this earlier using 6.05

lhupfeldt, 2023-05-21:
Forgot to mention that I have also done a `git pull` since last successful build.

mstegen, 2023-05-23:
I'm sorry, but i'm unable to help you on this.
I'm using MPLABX on WIN10.
Using the same PIC18F-K_DFP version 1.1.58

If it's only this error, you might comment out the "read serialnr" function where tblptr is used.

bobosch, 2023-05-24:
I updated to MPLABX IDE 6.10 and XC8 compiler 2.41 - works fine with linux here.

bobosch, 2023-05-24:
Seems that there are some lines missing on your snipset
```
EVSE.c:3103:86: warning: (373) implicit signed to unsigned conversion
::: advisory: (2051) the current license does not permit the selected optimization level, using optimization level 2
::: advisory: (2051) the current license does not permit the selected optimization level, using optimization level 2
OneWire.c:184:43: warning: (373) implicit signed to unsigned conversion
OneWire.c:205:40: warning: (373) implicit signed to unsigned conversion
OneWire.c:230:44: warning: (373) implicit signed to unsigned conversion
OneWire.c:263:22: warning: (373) implicit signed to unsigned conversion
::: advisory: (2051) the current license does not permit the selected optimization level, using optimization level 2
GLCD.c:92:28: warning: (373) implicit signed to unsigned conversion
GLCD.c:99:35: warning: (373) implicit signed to unsigned conversion
GLCD.c:101:30: warning: (373) implicit signed to unsigned conversion
GLCD.c:138:22: warning: (373) implicit signed to unsigned conversion
GLCD.c:161:22: warning: (373) implicit signed to unsigned conversion
GLCD.c:165:18: warning: (373) implicit signed to unsigned conversion
GLCD.c:173:31: warning: (373) implicit signed to unsigned conversion
GLCD.c:177:18: warning: (373) implicit signed to unsigned conversion
GLCD.c:198:21: warning: (373) implicit signed to unsigned conversion
GLCD.c:201:29: warning: (373) implicit signed to unsigned conversion
GLCD.c:222:38: warning: (373) implicit signed to unsigned conversion
GLCD.c:271:40: warning: (373) implicit signed to unsigned conversion
GLCD.c:274:34: warning: (373) implicit signed to unsigned conversion
GLCD.c:288:58: warning: (373) implicit signed to unsigned conversion
::: advisory: (2051) the current license does not permit the selected optimization level, using optimization level 2
::: advisory: (2051) the current license does not permit the selected optimization level, using optimization level 2
utils.c:39:28: warning: (373) implicit signed to unsigned conversion
utils.c:105:130: warning: (373) implicit signed to unsigned conversion
utils.c:139:28: warning: (373) implicit signed to unsigned conversion
::: advisory: (2051) the current license does not permit the selected optimization level, using optimization level 2
::: advisory: (2051) the current license does not permit the selected optimization level, using optimization level 2
modbus.c:648:44: warning: (373) implicit signed to unsigned conversion
modbus.c:648:129: warning: (373) implicit signed to unsigned conversion
modbus.c:651:40: warning: (373) implicit signed to unsigned conversion
modbus.c:664:27: warning: (373) implicit signed to unsigned conversion
modbus.c:665:31: warning: (373) implicit signed to unsigned conversion
modbus.c:666:27: warning: (373) implicit signed to unsigned conversion
modbus.c:680:15: warning: (373) implicit signed to unsigned conversion
modbus.c:696:99: warning: (373) implicit signed to unsigned conversion
modbus.c:806:36: warning: (373) implicit signed to unsigned conversion
modbus.c:849:60: warning: (373) implicit signed to unsigned conversion
"/opt/microchip/xc8/v2.41/bin/xc8-cc"  -mcpu=18F26K22 -Wl,-Map=dist/default/production/SmartEVSE2.X.production.map  -DXPRJ_default=default  -Wl,--defsym=__MPLAB_BUILD=1   -mdfp="/home/robert/.mchp_packs/Microchip/PIC18F-K_DFP/1.1.58/xc8"  -fno-short-double -fno-short-float -memi=wordwrite -mrom=0-FCFB -O3 -maddrqual=ignore -xassembler-with-cpp -mwarn=-3 -Wa,-a -msummary=-psect,-class,+mem,-hex,-file  -ginhx32 -Wl,--data-init -mno-keep-startup -mno-download -mdefault-config-bits -std=c90 -gdwarf-3 -mstack=compiled:auto:auto:auto      -Wl,--memorysummary,dist/default/production/memoryfile.xml -o dist/default/production/SmartEVSE2.X.production.elf  build/default/production/EVSE.p1 build/default/production/GLCD.p1 build/default/production/bootloader.p1 build/default/production/utils.p1 build/default/production/modbus.p1 build/default/production/OneWire.p1 build/default/production/font2.p1 build/default/production/font.p1
::: advisory: (2051) the current license does not permit the selected optimization level, using optimization level 2
Non line specific message::: advisory: (1492) using updated 32-bit floating-point libraries; improved accuracy might increase code size
modbus.c:767:: warning: (765) degenerate unsigned comparison

bobosch, 2023-05-25:
This is version 2.30, here is the latest:
[SmartEVSE2.X.production.hex.zip](https://github.com/SmartEVSE/SmartEVSE-2/files/11568977/SmartEVSE2.X.production.hex.zip)

bobosch, 2023-05-27:
@lhupfeldt Does the phase count detection (new feature in latest version) works on your setup? I've changed the balancing algorithm in solar mode depending on the charging phases here:
[SmartEVSE2.X.beta.hex.zip](https://github.com/SmartEVSE/SmartEVSE-2/files/11581267/SmartEVSE2.X.beta.hex.zip)

lhupfeldt, 2023-05-29:
@bobosch Sorry, I have not been at home for the last couple of days, so I did not attempt to load the hex file yet. Would you like me to load the [SmartEVSE2.X.production.hex.zip](https://github.com/SmartEVSE/SmartEVSE-2/files/11568977/SmartEVSE2.X.production.hex.zip)  to test that? Or [SmartEVSE2.X.beta.hex.zip](https://github.com/SmartEVSE/SmartEVSE-2/files/11581267/SmartEVSE2.X.beta.hex.zip) ? I can try to load either if you want me to test.

bobosch, 2023-05-31:
Please test the beta.hex - if you are facing issues on balancing you can fall back to the production.hex

lhupfeldt, 2023-06-25:
Hi @bobosch I finally got around to trying the beta.hex.
Now I just need to know what you want me to test :)
Where is the phase count supposed to show up?
The main display, or in a menu?

https://github.com/SmartEVSE/SmartEVSE-2/assets/1584329/41dcc5ac-87da-4d97-b692-327b131a33cb

lhupfeldt, 2023-06-25:
BTW, the small fonts on the main display are hard to read outside through the enclosure door plastic. It would be great with a slowly toggling display with large fonts.

bobosch, 2023-06-26:
> Now I just need to know what you want me to test :)

The automatic phase detection and the balancing (keep the mains current at 0 A while solar charging)

bobosch, 2023-06-26:
> BTW, the small fonts on the main display are hard to read outside through the enclosure door plastic

Even when the backlight is on?

lhupfeldt, 2023-06-26:
> > Now I just need to know what you want me to test :)
>
> The automatic phase detection and the balancing (keep the mains current at 0 A while solar charging)

You want all three phases to show 0 on the SmartEVSE main display while solar charging?
I'm afraid I may need a more specific description of what you want me to look for :)

bobosch, 2023-06-27:
> It is normally off and it would be nice to be able read the display when the enclosure door is closed.

I have also a enclosure, but when the backlight is on the small font is readable. When the backlight is off even the big font is not good readable.
While charging most of the information is shown with the big font - what do you miss?

Thread 60 (2024-11-08):

Old sensorbox comm's died when updated SmartEVSE v2 to 2.3

juntta, 2024-11-08:
I’ve got two SmartEVSE v2 in smart mode which I have to upgrade v2 to newer version to support external switch.

After I updated both v2’s I’ve been getting ”no serial com, check wiring” errors. Wiring was as it was before and I double checked config menu and everything should be in order also.

Isn’t the old sensorbox (v1.1) compatible any more with 2.20 and newer versions? Is the sensorbox possible to update with ftdi cable (or some other means)?

mstegen, 2024-11-08:
If you use an old sensorbox 1.0 or 1.1 then it's not compatible anymore with the latest smartEVSE v2 firmware.
The latest versions use modbus, while the old version used a different (slower) protocol.

You can flash the sensorbox 1 to a newer firmware (available in the sensorbox 1 repo), but you will need to use the pickit or other microchip programmer to program it.

juntta, 2024-11-08:
I got the sensorbox updated with Pickit programmer and now smartmode on SmartEVSE v2 functions normally.

Thanks @mstegen

Closed 2024-11-08.

Thread 61 (2025-09-28):

Phase 1,2,3 and Ʃ amps not displayed (all zero)

PJvLit, 2025-09-28:
I've uploaded version 2.40 after having used version 2.04 since March 2019.
I also updated to the new sensor box (Sensorbox plus, bi-directional without UTP)
Although in smart and solar mode it does start loading it does not show the amps in the display.
It also does not seem to take the reading from the sensorbox to switch solar loading on or off .
Is calibrating the the Sensorbox plus is based on the sum of the CT1,2,3 Amps or a on single CT1 Amp?

I've put:
 - START at 0 and - 1,6, 10   --> no change
 - STOP Disabled, 1, 5, 10 min --> no change
 - Import 0 , 6 Amp  --> no change

Also I not sure I understand the external SWITCH correctly?
In previous version (2.04) it was a momentary push button ON/OFF (toggle between states).
Now it is, is it?;
 - Disabled: --> no switch used
 - Access B: --> ON/OFF momentary push button (toggles between states)
 - Access S: --> ON/OFF switch
 - Sma-Sol B: --> Smart/Solar momentary push button (toggles between states)
                            needs a prolonged press (~2 seconds)
 - Sma-Sol S: --> Smart/Solar switch

**Idea: why for the B button combine function to:**
 short press B: -->     ON<->OFF   momentary push button (toggles between ON/OFF states)
 long  press B: --> Smart<->Solar momentary push button (toggles between Smart/Solar states).

Finally, have a setting that gives the possibility to:
have one relay being used for either as Locking Actuator or as 2nd Contactor for phases 2 and 3.
