SmartEVSE/SmartEVSE-2/eagle/SmartEVSEv2.2.pdf

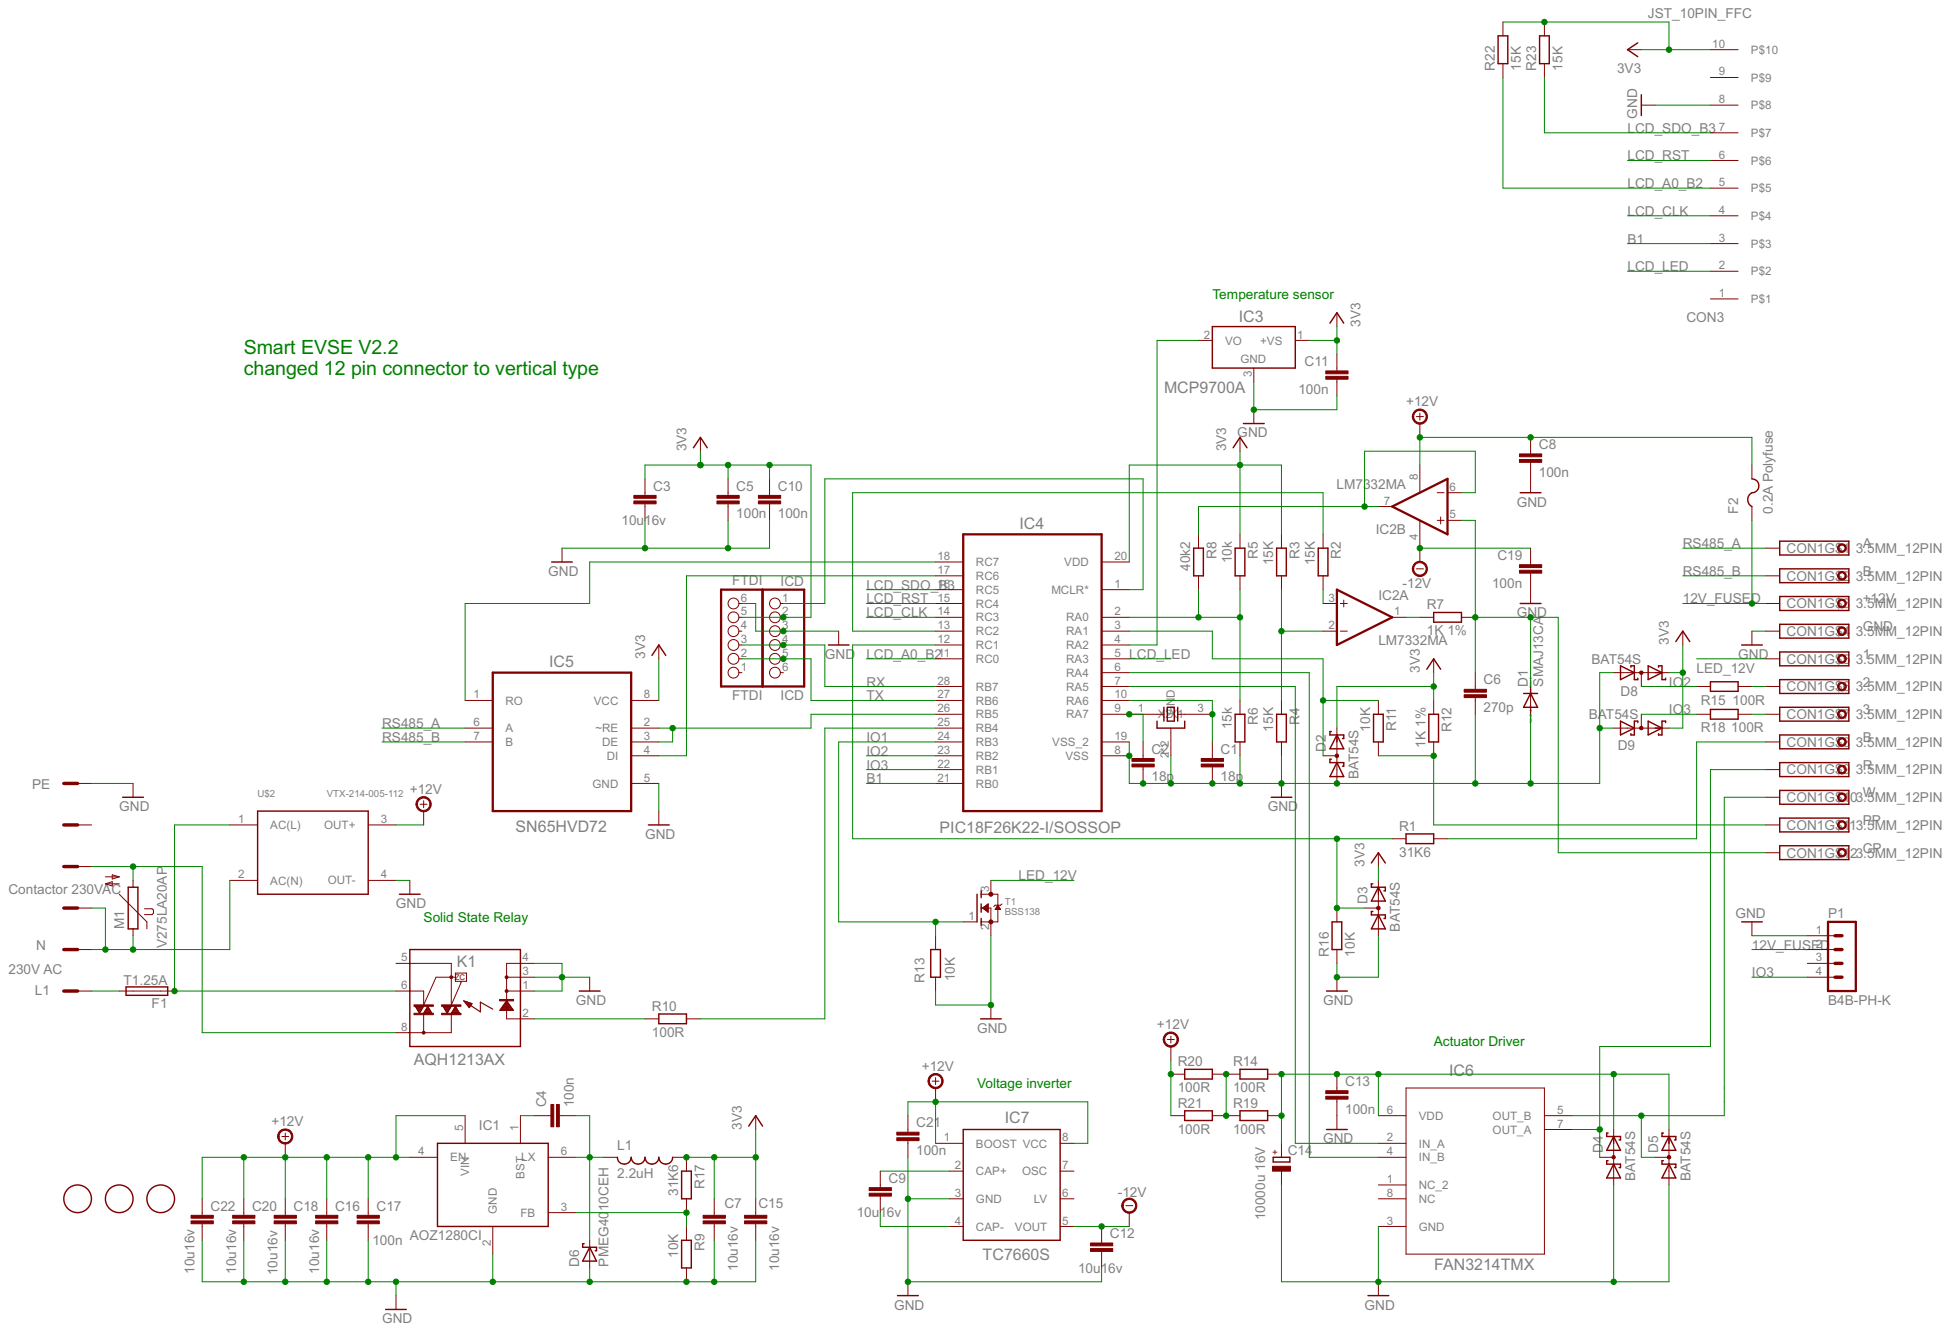
[picture p7: page 1]

Smart EVSE V2.2
changed 12 pin connector to vertical type

4 5 | 3 RA2 4 RA3 LCD_LED
