SmartEVSE/SmartEVSE-2/eagle/LCD_boardv2.pdf

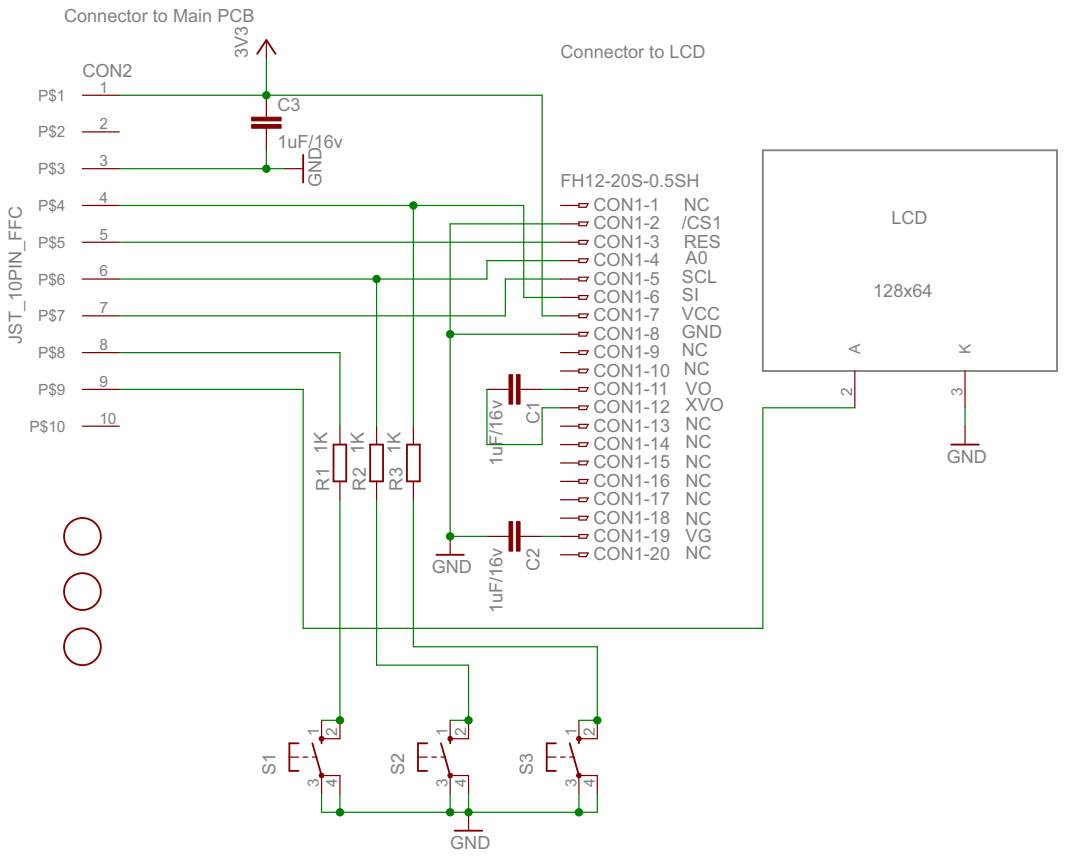
[picture p8: page 1]
