SmartEVSE/SmartEVSE-2/(commit log)

2017-08-28 Smart EVSE v2 code and pcb files
    [LCD_boardv2.brd, LCD_boardv2.sch, SmartEVSEv2.brd, SmartEVSEv2.sch]
2019-02-18 Version 2.04
    In version 2.04 we added support for external stop button, a 12V LED on IO1.
    The external 12V LED requires a hardware change (hw ver 2.1)
2019-04-24 Version 2.05 + 2.06
    2.05 Fix: Using a 16A charge cable would limit MaxCurrent to 16A, until a reset of the module or adjusting the MAX value using the menu.
    Fix: Increased number of times a STATE change needs to be valid, before the actual STATE change takes place.
    LCD Backlight will now be activated on any key press, and will turn off after 30 seconds of inactivity (except when charging).
    CT's default values can be restored by holding both < and > keys while in the CAL menu.
    RCMON menu option added. This adds support for DC Residual Current sensors, as required by IEC62955.
    IO3 is used as the fault input (active high).
    The error state can be reset by p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
    [EVSE.c, EVSE.h, GLCD.c, GLCD.h]
2019-05-29 Bugfixes - Move U1packet buffer into main loop - Modbus packet length check - Modbus request response detection - Reset no communication timer on broadcast receive
    [EVSE.c]
2019-05-30 Bugfix: Send Modbus Requests only on Load Balancing: Disabled or Master
    [EVSE.c]
2019-06-01 Multiplier 10 on ChargeCurrent missing on some lines
    [EVSE.c]
2019-06-01 Switch modbus receive packets from SmartEVSE in 3 categories: DataReceived = 1 : Measurement from electric meter DataReceived = 2 : Communication from Master to Slave DataReceived = 3 : Communication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
2019-06-02 Modbus implementation to read and set configuration options: Register 0xC*: Configuration 0xC0: CONFIG 0xC1: MODE 0xC2: START 0xC3: STOP 0xC4: LOADBL 0xC5: MIN 0xC6: CABLE 0xC7: LOCK 0xC8: ACCESS 0xC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
2019-06-03 Modbus read status values: 0xA0: State 0xA1: Error 0xA2: Charging current
    [EVSE.c, EVSE.h]
2019-06-03 Bugfix: Do not show help on EXIT MENU
    [EVSE.c]
2019-06-04 Create function "updateCurrentData" for processing received current measurement
2019-06-04 Bugfix: Show MAINS and MIN option also in load balancing mode
    [EVSE.c]
2019-06-05 Bugfix: Disable receive of Mains electric meter packets if mode is normal Bugfix: Sync MODE and MAX with slaves
    [EVSE.c, EVSE.h]
2019-06-10 Correct values in modbus register check
    [EVSE.c]
2019-06-10 Bugfix: Use variable CT1 in GLCD sensorbox calibration instead of ICal
    [GLCD.c]
2019-06-10 Avoid variable conversion to reduce compiler warnings
    [EVSE.c, EVSE.h]
2019-06-14 - Created modbus register mapping function - Send modbus exception if register is invalid - Make "Access_bit" writeable over modbus, independent of the "Switch" option.
2019-06-14 Add Switch option "Smart-Solar" to choose with an external switch between smart and solar charging Rename Access variable/constant to Switch
2019-06-15 For switch mode Smart-Solar device must be in Solar mode
2019-06-15 Add Switch IO2 option for Access Switch and Smart-Solar Push-Button
2019-06-15 Also don't reset Access_bit if Switch is Access Switch
    [EVSE.c]
2019-06-16 Differ between Sensorbox 2 with P1 or CT data
2019-06-16 Bugfix in Modbux FC=16 write multiple
    [EVSE.c]
2019-06-16 Always show config option "MAX" as it can also limit current on Slave EVSE
2019-06-19 Eastron SDM630 current is unsigned -> Get sign from power register
2019-06-20 Remove Sensorbox v1 compatibility code
2019-06-20 Sensorbox calibration bugfixes
2019-06-20 Add visualisation for solar mode and solar stop timer
2019-06-20 Bugfix: Also write settings if set by broadcast
    [EVSE.c]
2019-06-25 Remove Sensorbox 1 configuration option
2019-06-25 Update EVSE mode on slave when changed by switch
2019-07-23 Bugfixes
    Fixed Issues:
    - Check if sensorbox calibration procedures working
    - Slave should immediately disconnect power from cable on disconnect.
    Fixed Bugs:
    - clear chargedelay when switching from Solar to Smart Mode.
    - disable Solar stop timer when switching between Solar to Smart Mode.
    - garbled screen when exiting menu.
    - if access is disabled, it is not shown in Smart or Solar mode (in normal mode ACCESS DENIED is
    displayed)
    Added:
    V Indicate solar stop timer with a little clock and the time m:ss
    [EVSE.c, GLCD.c]
2019-10-29 Master/Slave bugfixes, Circuit option added
    Cable option removed, replaced with Circuit option.
    Switching between Solar/Smart mode with left button on SmartEVSE module
    [EVSE.c, EVSE.h, GLCD.c]
2019-10-31 V2.07 fixed RCD trip due to inductive loads.
    Bootloader can now only be entered when also the right button on top of the module is pressed.
    Added Compile time option to switch directly from STATE_A to STATE_C.
    [EVSE.c, EVSE.h]
2019-11-08 Updated Schematics
    Updated schematic and board to version 2.2
    [SmartEVSEv2.2.brd, SmartEVSEv2.2.sch]
2020-01-02 Version 2.12 fixes garbled LCD
    2.11 Fixed rare corrupted flash issue, seems to happen sometimes at power on.
    Bootloader also gets updated to fix this issue (now v1.06)
    MAX setting now starts at 6A
    2.12 Fixed garbled LCD.
    [EVSE.c, EVSE.h, GLCD.c]
2020-01-26 Version 2.13 Master/Slave communication bug fixes.
    Various Master/Slave communication bug fixes.
    created utils/bootloader/math.c files, as the main sourcefile became too large
    [EVSE.c, EVSE.h, GLCD.c, bootloader.c, bootloader.h, utils.c, utils.h]
2020-01-26 Master/Slave communication bug fixes.
    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
    [EVSE.c, EVSE.h, GLCD.c, GLCD.h, bootloader.c, bootloader.h, utils.c, utils.h]
2020-01-28 version 2.14 Fixed Broadcast error message handling
    Fixed Broadcast error clear message handling on slave.
    Added check in Solar mode for overloading the MAINS.
    Removed START and STOP menu options from the slave, as it is determined by the master.
    [EVSE.c, EVSE.h]
2020-06-04 version 2.16 Added Import / Grid menu option, bugfixes
    2.15 Added check to see if Sensorbox data contains new measurement data.
    - Added IMPORT menu option, which allows for power import from the grid when solar charging.
    - Added compile time option to compensate for 230V-400V transformers.
    - Added Activation mode, which is triggered if state C is not entered within 30 seconds.
    - If an external push button is used as Smart/Solar mode switch, holding this button for 1.5 seconds will now stop charging.
    2.16 Fixed Smart/Solar mode switch, it would force Solar or Smart mode, even in Normal mode.
    - Added GRID menu option. Configures the Sensorbox2 for use with 4Wire (L1,L2,L3 and Neutral) or 3Wi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
    [EVSE.c, EVSE.h, GLCD.c, utils.c]
2020-06-08 version 2.17 Solar mode state switch bugfix. Hides the CAL menu when not used
    Fixed state switch bug while in solar mode.
    Hides CAL menu option when CT's are not used.
    [EVSE.c, EVSE.h]
2020-06-26 Make Modbus Register 0xA6 Charging current writeable
2020-10-20 Use same variable in getMenuItemOption MENU_STOP case
2020-10-20 Disable solar timer when switch to smart mode
2020-10-23 - Add EV meter option - Display charged amount of energy
2020-10-25 - Show temperature in menu - Allow negative temperature - Bugfix showing temperature error message
    [EVSE.c, EVSE.h, GLCD.c]
2020-10-25 Center message "READY" with chargedelay
2020-12-01 Increased MaxMains to 200A, and Circuit to 160A
2020-12-03 Extend EMConfig struct with Modbus function and voltage register information
2020-12-06 Extend custom electric meter configuration (add option for voltage, power and energy, and allow registers up to 65535)
2020-12-06 Auto repeat button press when holding it down
2020-12-25 Swap MENU_MAX and MENU_CIRCUIT on modbus configuration (MAX is EVSE specific, CIRCUIT system specific)
    [EVSE.c, EVSE.h, modbus.c]
2020-12-25 Replace printf line endings from Windows to UNIX
    [EVSE.c]
2020-12-27 Move new line character in LOG_* printf to the beginning
2021-01-14 Show real charging power in Smart/Solar mode
2021-01-15 Switch on backlight when removing charging cable
2021-01-16 Simplify GLCD text rotation and add charging power
2021-01-22 Make the Solar Stop timer work on nodes
2021-01-22 Remove unused NOCURRENT error
    [EVSE.c, EVSE.h]
2021-01-22 Bugfix: Extend Str in GLCD to 11 chars
    [GLCD.c]
2021-01-23 Use modbus status register for broadcast error and solar timer
    [EVSE.c, EVSE.h]
2021-01-28 Use signed int/long instead of signed double for all current calculations
2021-01-28 Filter only Sensorbox from EV electric meter
2021-01-28 Repeat button press after 0.5 second
2021-04-05 Solving (all but 1) level -2 parser/compiler errors
    Removed all "far" qualifiers as per
    MPLAB® C18 to XC8 C Compiler
    Migration Guide, section 3.9.1 and 3.10.1
    Altered few data types / typecasts
    Code now compiles with just 1 warning (765) on line 625 of modbus.c on XC8 Compiler Warning level -2
    Code compiled successfully with
    MPLAB X IDE v5.45
    XC8 (v2.32)
    Pack,PIC18F-K_DFP,1.1.58
    ...and works on the target controller :-)
    [EVSE.c, EVSE.h, GLCD.c, GLCD.h, bootloader.c, modbus.c]
2021-04-08 Update EVSE.c
    Reverted the removal of "unsigned" on char LCDpos, following comment mstegen
    Updated comment on static unsigned char Str[10]; as per comment maximevince
    [EVSE.c]
2021-04-12 Update Charge current broadcast documentation
2021-04-26 Fix cast error in receiveMeasurement
    Sensorbox data (double) was rounded to the Amp, all fractional data was not converted to the signed long.
    [modbus.c]
2021-05-11 Fix int cast for Irms[x]
    [EVSE.c]
2021-05-13 Solved some "implicit signed to unsigned conversion" compiler warnings
    [EVSE.c, GLCD.c, OneWire.c, bootloader.c, modbus.c, utils.c]
2021-08-16 Interrupt sending modbus requests for 4 seconds when receiving requests from another device to avoid collisions
    [EVSE.c]
2021-11-26 Compare start current value with sum of available current
2021-11-26 Cleanup and fix RS232 CLI
    [EVSE.c, EVSE.h]
2021-12-10 Automatic start current
2021-12-10 Add compile flag to import current only when minimum current is not available
2022-01-02 Reorder functions of GLCD.c to avoid definitions in the header file
    [GLCD.c, GLCD.h]
2022-01-06 Fix StartCurrent detection with shared EV electric meter
    [EVSE.c, EVSE.h]
2022-01-07 Clean up the GLCD write/print functions
2022-02-25 WiFi option for Sensorbox 2
2022-02-28 Fix alignment of currents <= -100A
    [GLCD.c]
2022-06-04 Use constants for Switch values
2022-06-04 Allow Smart/Solar switch on a node
2022-06-17 Increase external button bounce delay
2022-06-17 Try to broadcast communication error to Nodes
    [EVSE.c]
2022-06-28 Stabilize balancing, especially when charging on three phases
    [EVSE.c]
2022-07-03 Remove ResetBalancedStates and reset node state when node goes offline
    [EVSE.c, EVSE.h]
2022-07-05 Changing MaxCurrent on a node should change ChargeCurrent
2022-07-10 On automatic StartCurrent detection pause SolarStopTimer and print "DETECT" instead of the time
2022-07-10 Store charging interval time (Node.IntTimer) instead of charging time (Node.Timer) and reset it when not charging
    [EVSE.c, EVSE.h]
2022-07-12 Change ChargeTimer to ChargeDelay
2022-07-12 Add CAPACITY menu option to limit max current draw on MAINS (sum of phases)
2022-07-17 Delay with minimum current when start solar charging
2022-07-28 Move StartCurrent detection back to BalancedLeft block to fix overcurrent protection
    [EVSE.c]
2022-08-24 Count phases when start charging and increasing current
2022-10-07 Always detect used phases and minimum start current
2023-05-22 Change balancing current in dependence of used phases
2024-11-17 Revert "Add compile flag IMPORTCURRENT_SUM"
    This reverts commit a58c5cc8a43e6416b9944f0efc9aade767d5cdab.
    [EVSE.c, EVSE.h]
2024-11-17 Revert "Add compile flag to import current only when minimum current is not available"
    This reverts commit b784585f1a3091bb39330b42a2c2f88c417d3b3e.
    [EVSE.c, EVSE.h]
2024-11-17 Stop solar charging only when over 6 A (per phase) more than StartCurrent is used
2024-11-17 Revert "Automatic start current"
    This reverts commit 79d0da0f6e69825656b1a878b250756490106ba9.
    [EVSE.c, EVSE.h]
2024-11-17 Correct call of sprintf
    [GLCD.c]
2024-11-18 Fix StartCurrent and ImportCurrent in serial console
    [EVSE.c, EVSE.h]
